fpt/tang-tiny-gpu/rtl/vdp/line_compositor.sv

// ラインごとの合成 (docs/ARCHITECTURE.md の段階 E1。M4 の fb_scanout を置き換えた)
//   論理画面 SRC_W x SRC_H を、ライン単位で合成して縦横 2 倍で出す。
//
//   合成: ラインを始めるときにレイヤのレジスタ (背景色・レイヤの有効・ビットマップの透過色と順位・タイル レイヤとスプライトの設定) を
//         取り込み、順位の付いた作業ライン (ピクセルごとに {順位, 色}) に、レイヤごとのパスで書く。
//         1. スプライト (有効なら): sprite_layer が OAM の順に出すピクセル。作業ラインがまだ空 (順位 0) のところだけ書くので、
//            スプライト同士は優先度ビットによらず OAM の前のものが勝つ (メガドラ・SNES と同じ)。順位は優先度ビットで RANK_S_LO / RANK_S_HI
//         2. タイルの面 (有効なら): 1 つの tile_layer を設定を変えて順に動かす。順位はタイルの優先度ビットで決まる
//            a. 面 B: RANK_B_LO / RANK_B_HI
//            b. 面 A: RANK_A_LO / RANK_A_HI。ウィンドウの範囲は書かない
//            c. ウィンドウ (範囲があるラインだけ): 面 A と同じ順位で、ウィンドウの範囲だけ書く。スクロールしない 64 x 32 のマップ
//               (win_map_base)。タイルの場所・パレットのバンク・エントリの並びは面 A のもの
//            ウィンドウの範囲 (メガドラと同じ): win_v ([5] 下, [4:0] 位置 x 8 ライン) でラインの上 / 下、
//            win_h ([5] 右, [4:0] 位置 x 16 ピクセル) で左 / 右。ラインが縦の範囲に入ればライン全体、でなければ横の範囲
//         3. ビットマップ レイヤ (有効なら): SDRAM のフレームバッファの行をバーストで読む。順位は bitmap_rank (既定 1)。
//            透過色が有効なら、透過色のピクセルは書かない。
//            8bpp (bitmap_fmt = 1) のときは行 (80 ワード) をいったん bm_buf に読み、1 クロックに 1 ピクセルずつパレット (0..255) を引いて書く。
//            透過色は bitmap_key[7:0] (パレットの番号)
//         4. 出力: 作業ラインをライン バッファに写し (順位 0 = どのレイヤも書かなかったところは背景色)、作業ラインを空に戻す。
//            ライトマップが有効 (layer_ctrl[5]) なら、ここで色にセルの倍率を掛ける (K4、下の「ライトマップ」)。行の倍率と加算 (霧、E7) もここ
//         2 と 3 は「不透明で、順位が今の値より大きいピクセルだけ」書くので、パスの順番によらず順位の高いものが残る (同じ順位なら先のパス)。
//         順位 (3bit): 0 背景色、1 面 B (低)、2 面 A (低)、3 スプライト (低)、4 面 B (高)、5 面 A (高)、6 スプライト (高)。
//   横スクロールの表 (hs_mode != 0): ラインを始めるときに VRAM の hs_base + 番号 の 1 ワードを読み、[25:16] を面 A、[9:0] を面 B の
//         横スクロールの値にする (メガドラの表をビッグエンディアンの 32bit ワードで読んだ並び。値の向きもメガドラと同じで、
//         正の値で面が右に動く = scroll_x = -値)。番号は hs_mode 1: 0 (画面全体)、2: ライン & ~7 (8 ラインごと)、3: ライン
//   VRAM (16K ワード x 32bit) とパレット (512 x RGB565) はここに置き、読み出しのポートを横スクロールの表・スプライト・タイルのパスが順番に使う。
//   Mode 7 (E7、mode7_layer.sv): M7_CTRL bit0 なら、面 A のタイルのパスの代わりに mode7_layer がピクセルを出す (順位は面 A と同じ。
//         ウィンドウは描かない)。ラインの先頭の計算 (setup) は横スクロールの表を読んだ直後に始め、スプライト・面 B のパスと同時に動く。
//         M7_CTRL[3:2] が 1 なら行列 {B, A}, {D, C} を VRAM の m7_tbl + 2 * ライン から、2 なら遠近の奥行き z を m7_tbl + ライン から読む
//   霧 (E7): 出力のパスで、各色 c を min(最大値, ((c * L_eff) >> 4) + ADD) にする。L_eff = min(63, (L_cell * L_line) >> 4)
//         (L_cell はライトマップのセル、ライトマップが無効なら 16)、L_line = LINE_MUL (5bit x 3、16 = 1 倍)、ADD = LINE_ADD (RGB565)。
//         LINE_FX_CTRL bit0 なら {LINE_ADD, LINE_MUL} を VRAM の LINE_FX_BASE + ライン から読む。既定 (16 x 3、0) なら出力は変わらない
//   E7 のレジスタ (GPU の REG_WRITE 32..50 → xreg_idx 0..18): 0 M7_SEL、1 M7_CTRL、2..5 M7_A..D、6 M7_X0、7 M7_Y0、8 M7_HOFS、9 M7_VOFS、
//         10 M7_MAP_BASE、11 M7_PAT_BASE、12 M7_TBL_BASE、13 M7_SX、14 M7_SY、15 LINE_MUL、16 LINE_ADD、17 LINE_FX_CTRL、18 LINE_FX_BASE
//   レジスタはラインの合成を始めるときに取り込むので、GPU の WAIT_LINE n のあとの REG_WRITE はライン n から効く。
//   そのために、合成を始めるたびに line_start とライン番号 line_num を出す。
//
//   ビットマップ: ソースのライン y はワードアドレス (fb_base + y) * 256 から SRC_W / 2 ワード (8bpp は SRC_W / 4 ワード)。
//                 RGB565 は 1 ワードに 2 ピクセル (下位 16bit が偶数の x)、RGB565 = {R5, G6, B5}。
//                 8bpp は 1 ワードに 4 ピクセル (ピクセル x はバイト x % 4)
//   動き方:       ソースのライン n を表示しているあいだ (出力 2 ライン分) に、ライン n+1 を合成して 2 ライン分のライン バッファの
//                 空いているほうに書く。ライン 0 は最後から 2 本目のブランキング ラインで合成する (ほかのラインと同じく出力 2 ライン分の時間がある)。
//                 表示が始まるときに合成が終わっていなかったら underflow_count を 1 増やす。
//   fb_base:      ライン 0 を合成し始めるときにだけ取り込み、そのフレームの間は変えない。取り込んだクロックで base_latched を出す。
//   印:           mark_req を受けると、次にライン 0 から合成するフレームに印を付ける (mark_toggle を反転)。
//                 frame_crc がそのフレームの CRC を MARK_CRC に残す。ラインごとにレジスタを変えたフレームを比べるため。
//
//   ライトマップ: 8 x 8 ピクセルのセルごとの R, G, B の倍率 (6bit ずつ、16 = 1 倍、63 = 3.94 倍)。セル (cx, cy) は番号 cy * (SRC_W / 8) + cx
//                 (320 x 240 なら 40 x 30 = 1,200 セル)。出力のパスで、ピクセル (x, y) の各色 c に
//                 セル (x / 8, y / 8) の倍率 L を掛けて min(最大値, (c * L) >> 4) にする (背景色にも掛かる)。GPU の LIGHT_WRITE が書く
//   クロック: ピクセル側 (clk_pix) が「次のライン」をトグルで頼み、システム側 (clk_sys) が合成する。
//            頼むライン番号はトグルの前に確定し、次に頼むまで (出力 2 ライン以上) 変わらない。
//            表示 (vdp_video の fb_en) にかかわらず、映像のタイミングが動いていれば合成し続ける (WAIT_LINE が止まらないように)。
module line_compositor #(
    parameter int SRC_W   = 320,
    parameter int SRC_H   = 240,
    parameter int V_TOTAL = 525,
    parameter int VRAM_WORDS = 16384
) (
    // --- システムクロック側 ---
    input  logic        clk_sys,
    input  logic        rst_sys,
    input  logic [12:0] fb_base,          // 256 ワード単位。ライン 0 を合成し始めるときに取り込む
    output logic        base_latched,     // fb_base を取り込んだとき 1 クロック
    input  logic [15:0] bg_color,         // 背景色 (RGB565)
    input  logic [5:0]  layer_ctrl,       // bit0: ビットマップ レイヤ有効, bit1: ビットマップの透過色を有効, bit2: 面 A (とウィンドウ) 有効,
                                          // bit3: スプライト有効, bit4: 面 B 有効, bit5: ライトマップを掛ける
    input  logic [15:0] bitmap_key,       // ビットマップの透過色
    input  logic [2:0]  bitmap_rank,      // ビットマップ レイヤの順位 (既定 1)
    input  logic        bitmap_fmt,       // ビットマップの形式: 0 = RGB565、1 = 8bpp (パレットの番号)
    input  logic [9:0]  tile_scroll_x,    // 面 A (tile_layer.sv)
    input  logic [9:0]  tile_scroll_y,
    input  logic [13:0] tile_map_base,
    input  logic [13:0] tile_pat_base,
    input  logic [7:0]  tile_ctrl,
    input  logic [9:0]  tileb_scroll_x,   // 面 B
    input  logic [9:0]  tileb_scroll_y,
    input  logic [13:0] tileb_map_base,
    input  logic [13:0] tileb_pat_base,
    input  logic [7:0]  tileb_ctrl,
    input  logic [5:0]  win_h,            // ウィンドウ: {右, 位置 x 16 ピクセル}
    input  logic [5:0]  win_v,            //             {下, 位置 x 8 ライン}
    input  logic [13:0] win_map_base,
    input  logic [1:0]  hs_mode,          // 横スクロールの表: 0 なし (レジスタ)、1 画面全体、2 8 ラインごと、3 ラインごと
    input  logic [13:0] hs_base,
    input  logic [13:0] spr_pat_base,     // スプライト (sprite_layer.sv)
    input  logic [3:0]  spr_bank,
    input  logic [6:0]  spr_line_cols,
    input  logic        vram_we,          // VRAM・パレット・OAM の書き込み (GPU)。OAM は vram_waddr[7:0] と vram_wdata を使う
    input  logic [13:0] vram_waddr,
    input  logic [31:0] vram_wdata,
    input  logic        pal_we,
    input  logic [8:0]  pal_waddr,
    input  logic [15:0] pal_wdata,
    input  logic        oam_we,
    input  logic        light_we,         // ライトマップの書き込み: vram_waddr[10:0] のセルに {vram_wdata[21:16], [13:8], [5:0]}
    input  logic        xreg_we,          // E7 のレジスタの書き込み (GPU の REG_WRITE 32..50)
    input  logic [4:0]  xreg_idx,
    input  logic [15:0] xreg_data,
    input  logic        mark_req,         // 次のフレームに印を付ける (1 クロック)
    output logic        mark_toggle,      // 印を付けたフレームの合成を始めるたびに反転
    output logic        line_start,       // ラインの合成を始めたとき 1 クロック
    output logic [7:0]  line_num,         // 合成しているライン (line_start のあいだ有効、次まで保持)
    output logic        mem_req,
    output logic [20:0] mem_addr,
    output logic [8:0]  mem_len,
    input  logic        mem_ack,
    input  logic        mem_rvalid,
    input  logic [31:0] mem_rdata,
    output logic [7:0]  underflow_count,  // 飽和する
    // --- ピクセルクロック側 ---
    input  logic        clk_pix,
    input  logic        rst_pix,
    input  logic [10:0] x,                // 表示タイミング (video_timing の x, y)
    input  logic [9:0]  y,
    output logic [23:0] rgb               // x, y の 1 クロック後に有効
);
    localparam int WORDS = SRC_W / 2;
    localparam int VA_W  = $clog2(VRAM_WORDS);
    localparam logic [2:0] RANK_B_LO = 3'd1, RANK_B_HI = 3'd4, RANK_A_LO = 3'd2, RANK_A_HI = 3'd5,
                           RANK_S_LO = 3'd3, RANK_S_HI = 3'd6;

    // --- ライン バッファ (2 ライン x 256 ワード)。書き込みは clk_sys、読み出しは clk_pix ---
    logic [31:0] line_buf [0:511];

    // ================================================================ ピクセル側
    logic [8:0]  req_line;
    logic        req_toggle;
    logic        need;
    logic [8:0]  next_line;

    always_comb begin
        need      = 1'b0;
        next_line = '0;
        if (y == 10'(V_TOTAL - 2)) begin
            need = 1'b1;                                   // 最後から 2 本目のブランキング ライン: ライン 0
        end else if (y < 10'(2 * SRC_H - 2) && !y[0]) begin
            need      = 1'b1;                              // ライン n の 1 本目: ライン n+1
            next_line = 9'(y >> 1) + 9'd1;
        end
    end

    always_ff @(posedge clk_pix) begin
        if (rst_pix) begin
            req_toggle <= 1'b0;
            req_line   <= '0;
        end else if (x == 11'd0 && need) begin
            req_line   <= next_line;
            req_toggle <= ~req_toggle;
        end
    end

    logic [31:0] word;
    logic        upper;
    always_ff @(posedge clk_pix) begin
        word  <= line_buf[{y[1], x[9:2]}];   // ソースのライン y>>1 の偶奇でバッファを選ぶ
        upper <= x[1];
    end

    logic [15:0] p;
    assign p   = upper ? word[31:16] : word[15:0];
    assign rgb = {p[15:11], p[15:13], p[10:5], p[10:9], p[4:0], p[4:2]};

    // ================================================================ システム側
    // 作業ライン: ピクセルごとに {順位 3bit, 色 16bit}。偶数の x と奇数の x を別の BSRAM に置き、1 クロックに 2 ピクセル読み書きできる。
    // 書き込みは「不透明で、順位が今の値より大きいときだけ」。今の値は 1 クロック前に読んでおく (rd_addr を先に出す)
    logic [18:0] wl_even [0:255];
    logic [18:0] wl_odd  [0:255];
    logic [7:0]  wl_rd_addr;
    logic [18:0] wl_q_even, wl_q_odd;
    logic        wl_we_even, wl_we_odd;
    logic [7:0]  wl_wa_even, wl_wa_odd;
    logic [18:0] wl_wd_even, wl_wd_odd;

    always_ff @(posedge clk_sys) begin
        if (wl_we_even) wl_even[wl_wa_even] <= wl_wd_even;
        if (wl_we_odd)  wl_odd[wl_wa_odd]   <= wl_wd_odd;
        wl_q_even <= wl_even[wl_rd_addr];
        wl_q_odd  <= wl_odd[wl_rd_addr];
    end

    typedef enum logic [1:0] {TP_B, TP_A, TP_W, TP_NONE} tpass_t;      // タイルのパス
    typedef enum logic [3:0] {P_IDLE, P_HS, P_SPRITE, P_TILE, P_ISSUE, P_BITMAP, P_BM8, P_OUT_PRE, P_OUT} phase_t;
    phase_t phase;

    logic [2:0]  req_s;
    logic        busy, pending, mark_pending;
    logic        line_bank;      // 合成しているラインを書くバッファ (ライン番号の偶奇)
    logic [12:0] frame_base;     // このフレームで使う fb_base
    logic [7:0]  widx;           // ビットマップのパスで書くワード
    logic [7:0]  oidx;           // 出力のパスで書くワード
    // このラインのレジスタ (合成を始めるときに取り込む)
    logic [15:0] l_bg, l_key;
    logic        l_key_en, l_bm_en, l_tile_en, l_b_en, l_spr_en, l_fmt8, l_light;
    logic [2:0]  l_bm_rank;
    logic [9:0]  l_sx, l_sy;
    logic [13:0] l_map, l_pat;
    logic [7:0]  l_tctrl;
    logic [9:0]  l_bsx, l_bsy;
    logic [13:0] l_bmap, l_bpat;
    logic [7:0]  l_bctrl;
    logic [5:0]  l_wh, l_wv;
    logic [13:0] l_wmap;
    logic [1:0]  l_hs_mode;
    logic [13:0] l_hs_base;
    logic [9:0]  hs_a, hs_b;     // 横スクロールの表から読んだ値
    logic [13:0] l_spat;
    logic [3:0]  l_sbank;
    logic [6:0]  l_scols;
    logic [20:0] l_addr;         // ビットマップの行のアドレス
    // E7 のレジスタ (今の値) と、このラインの値
    logic [3:0]  m7_sel;         // M7_SEL の {[7:6], [1:0]}
    logic [3:0]  m7_ctrl;
    logic [15:0] m7_a, m7_b, m7_c, m7_d;
    logic [12:0] m7_x0, m7_y0, m7_hofs, m7_vofs;
    logic [13:0] m7_map, m7_pat, m7_tbl, fx_base;
    logic [9:0]  m7_sx;
    logic [8:0]  m7_sy;
    logic [14:0] fx_mul;
    logic [15:0] fx_add;
    logic        fx_tab;
    logic        l_m7, l_extbg, l_fx_tab;
    logic [1:0]  l_m7_tab, l_flip, l_over;
    logic [15:0] l_m7a, l_m7b, l_m7c, l_m7d, l_z;
    logic [12:0] l_x0, l_y0, l_hofs, l_vofs;
    logic [13:0] l_m7map, l_m7pat, l_m7tbl, l_fxbase;
    logic [9:0]  l_m7sx;
    logic [8:0]  l_m7sy;
    logic [14:0] l_mul;
    logic [15:0] l_add;
    logic [2:0]  rd_k;           // ラインの先頭で VRAM から読む表の番号 (横スクロール、Mode 7 の 2 語、霧)
    logic        m_setup, m_start, m_busy, m_valid, m_pri;
    logic [7:0]  m_next;
    logic [8:0]  m_x;
    logic [15:0] m_color;
    logic [13:0] m_vram_raddr;
    logic [8:0]  m_pal_raddr;
    logic        m7_pass;        // 面 A のパスを Mode 7 で描いている
    logic        t_start, t_busy, tl_busy;
    // 動かしているタイルのパス。yosys の FSM の抽出が符号を付け直すと $buf が残って nextpnr が置けないので、ふつうのレジスタのままにする
    (* fsm_encoding = "none" *) tpass_t tpass;
    logic [9:0]  t_sx, t_sy;
    logic [13:0] t_map, t_pat;
    logic [7:0]  t_ctrl;
    logic        t_valid, t_opaque, t_pri, tl_valid, tl_opaque, tl_pri;
    logic [7:0]  t_next, tl_next;
    logic [8:0]  t_x, tl_x;
    logic [15:0] t_color, tl_color;
    logic        s_start, s_busy;
    logic        s_valid, s_pri;
    logic [7:0]  s_next;
    logic [8:0]  s_x;
    logic [15:0] s_color;

    assign busy = phase != P_IDLE;

    // VRAM とパレット。読み出しは 横スクロールの表 (P_HS)、スプライトのパスのあいだ sprite_layer、それ以外は tile_layer
    logic [31:0] vram [0:VRAM_WORDS-1];
    logic [15:0] pal  [0:511];
    logic [13:0] vram_raddr, t_vram_raddr, s_vram_raddr, tl_vram_raddr;
    logic [8:0]  pal_raddr, t_pal_raddr, s_pal_raddr, tl_pal_raddr;
    logic [31:0] vram_q;
    logic [15:0] pal_q;
    logic [13:0] hs_addr;
    always_comb begin
        unique case (l_hs_mode)
            2'd2:    hs_addr = l_hs_base + 14'({line_num[7:3], 3'b000});
            2'd3:    hs_addr = l_hs_base + 14'(line_num);
            default: hs_addr = l_hs_base;
        endcase
    end
    // ラインの先頭で読む表: rd_k = 0 横スクロール、1 / 2 Mode 7 (直接は 2 語、遠近は 1 語)、3 霧
    logic [13:0] tab_addr;
    always_comb begin
        unique case (rd_k)
            3'd0:    tab_addr = hs_addr;
            3'd1:    tab_addr = (l_m7_tab == 2'd1) ? l_m7tbl + 14'({line_num, 1'b0}) : l_m7tbl + 14'(line_num);
            3'd2:    tab_addr = l_m7tbl + 14'({line_num, 1'b1});
            default: tab_addr = l_fxbase + 14'(line_num);
        endcase
    end
    assign vram_raddr = (phase == P_SPRITE) ? s_vram_raddr : (phase == P_HS) ? tab_addr : t_vram_raddr;
    // 8bpp のビットマップ: 行を読んでおくバッファと、パレットを引くパイプライン
    //   bi のクロック: bm_buf を読む → 1 段目 (p1): バイトを選んでパレットと作業ラインを読む → 2 段目 (p2): 作業ラインに書く
    logic [31:0] bm_buf [0:127];
    logic [31:0] bm_q;
    logic [8:0]  bi, p1_x, p2_x;
    logic        p1_v, p2_v, p2_tr;
    logic [7:0]  p1_idx;
    always_ff @(posedge clk_sys) begin
        if (phase == P_BITMAP && mem_rvalid) bm_buf[widx[6:0]] <= mem_rdata;
        bm_q <= bm_buf[bi[8:2]];
    end
    assign p1_idx = bm_q[{p1_x[1:0], 3'b0} +: 8];

    assign pal_raddr  = (phase == P_SPRITE) ? s_pal_raddr : (phase == P_BM8) ? {1'b0, p1_idx} : t_pal_raddr;

    always_ff @(posedge clk_sys) begin
        if (vram_we) vram[VA_W'(vram_waddr)] <= vram_wdata;
        vram_q <= vram[VA_W'(vram_raddr)];
    end
    always_ff @(posedge clk_sys) begin
        if (pal_we) pal[pal_waddr] <= pal_wdata;
        pal_q <= pal[pal_raddr];
    end

    sprite_layer #(.SRC_W(SRC_W)) u_sprite (
        .clk(clk_sys), .rst(rst_sys),
        .oam_we, .oam_waddr(vram_waddr[7:0]), .oam_wdata(vram_wdata),
        .vram_raddr(s_vram_raddr), .vram_q, .pal_raddr(s_pal_raddr), .pal_q,
        .start(s_start), .line(line_num), .pat_base(l_spat), .bank(l_sbank), .line_cols(l_scols), .busy(s_busy),
        .next_word(s_next), .px_valid(s_valid), .px_x(s_x), .px_pri(s_pri), .px_color(s_color)
    );

    tile_layer #(.SRC_W(SRC_W)) u_tile (
        .clk(clk_sys), .rst(rst_sys),
        .vram_raddr(tl_vram_raddr), .vram_q, .pal_raddr(tl_pal_raddr), .pal_q,
        .start(t_start && !m7_pass), .line(line_num), .scroll_x(t_sx), .scroll_y(t_sy), .map_base(t_map), .pat_base(t_pat),
        .ctrl(t_ctrl), .busy(tl_busy), .next_word(tl_next),
        .px_valid(tl_valid), .px_x(tl_x), .px_opaque(tl_opaque), .px_pri(tl_pri), .px_color(tl_color)
    );

    mode7_layer #(.SRC_W(SRC_W)) u_mode7 (
        .clk(clk_sys), .rst(rst_sys),
        .vram_raddr(m_vram_raddr), .vram_q, .pal_raddr(m_pal_raddr), .pal_q,
        .setup(m_setup), .line(line_num), .flip(l_flip), .over(l_over), .extbg(l_extbg), .persp(l_m7_tab == 2'd2),
        .a(l_m7a), .b(l_m7b), .c(l_m7c), .d(l_m7d), .z(l_z), .x0(l_x0), .y0(l_y0), .hofs(l_hofs), .vofs(l_vofs),
        .sx(l_m7sx), .sy(l_m7sy), .map_base(l_m7map), .pat_base(l_m7pat),
        .start(m_start), .busy(m_busy), .next_word(m_next),
        .px_valid(m_valid), .px_x(m_x), .px_pri(m_pri), .px_color(m_color)
    );

    // 面 A のパスを Mode 7 で描くとき (m7_pass)、タイルのパスの信号を mode7_layer のものにする
    assign m7_pass       = l_m7 && tpass == TP_A;
    assign m_start       = t_start && m7_pass;
    assign t_busy        = m7_pass ? m_busy : tl_busy;
    assign t_next        = m7_pass ? m_next : tl_next;
    assign t_valid       = m7_pass ? m_valid : tl_valid;
    assign t_x           = m7_pass ? m_x : tl_x;
    assign t_opaque      = m7_pass ? 1'b1 : tl_opaque;
    assign t_pri         = m7_pass ? m_pri : tl_pri;
    assign t_color       = m7_pass ? m_color : tl_color;
    assign t_vram_raddr  = m7_pass ? m_vram_raddr : tl_vram_raddr;
    assign t_pal_raddr   = m7_pass ? m_pal_raddr : tl_pal_raddr;

    // タイルのパスごとの設定 (パスのあいだは変わらない)
    logic hs_on;
    assign hs_on = l_hs_mode != 2'd0;
    always_comb begin
        unique case (tpass)
            TP_B: begin
                t_sx = hs_on ? 10'd0 - hs_b : l_bsx;  t_sy = l_bsy;
                t_map = l_bmap;  t_pat = l_bpat;  t_ctrl = l_bctrl;
            end
            TP_W: begin
                t_sx = '0;  t_sy = '0;
                t_map = l_wmap;  t_pat = l_pat;  t_ctrl = {l_tctrl[7:4], 2'd0, 2'd1};    // 64 x 32、面 A のバンクと並び
            end
            default: begin
                t_sx = hs_on ? 10'd0 - hs_a : l_sx;  t_sy = l_sy;
                t_map = l_map;  t_pat = l_pat;  t_ctrl = l_tctrl;
            end
        endcase
    end

    // ウィンドウの範囲
    logic [8:0] win_h16;
    logic [7:0] win_v8;
    logic       win_line, win_run, t_in_win;
    assign win_h16  = {l_wh[4:0], 4'b0};
    assign win_v8   = {l_wv[4:0], 3'b0};
    assign win_line = l_wv[5] ? line_num >= win_v8 : line_num < win_v8;
    assign win_run  = win_line || (l_wh[5] ? win_h16 < 9'(SRC_W) : win_h16 != 9'd0);
    assign t_in_win = win_line || (l_wh[5] ? t_x >= win_h16 : t_x < win_h16);

    // 次のタイルのパス: B → A → ウィンドウ の順に、有効なもの
    tpass_t     tp_first, tp_after;
    logic       en_w;
    assign en_w     = l_tile_en && win_run && !l_m7;      // Mode 7 のあいだはウィンドウを描かない
    // (Icarus Verilog は enum の三項演算子の代入を受け付けないので if で書く)
    always_comb begin
        if (l_b_en)         tp_first = TP_B;
        else if (l_tile_en) tp_first = TP_A;
        else if (en_w)      tp_first = TP_W;
        else                tp_first = TP_NONE;
        tp_after = TP_NONE;
        unique case (tpass)
            TP_B: if (l_tile_en) tp_after = TP_A; else if (en_w) tp_after = TP_W;
            TP_A: if (en_w) tp_after = TP_W;
            default: ;
        endcase
    end

    always_ff @(posedge clk_sys) req_s <= {req_s[1:0], req_toggle};

    // 作業ラインの読み出しアドレス: そのパスで次のクロックに書くところ
    always_comb begin
        unique case (phase)
            P_SPRITE: wl_rd_addr = s_next;
            P_TILE:   wl_rd_addr = t_next;
            P_BITMAP: wl_rd_addr = mem_rvalid ? widx + 8'd1 : widx;
            P_BM8:    wl_rd_addr = p1_x[8:1];
            P_OUT:    wl_rd_addr = oidx + 8'd1;
            default:  wl_rd_addr = 8'd0;
        endcase
    end

    // 作業ラインへの書き込み
    logic [2:0] t_rank, s_rank;
    logic       t_ok, bm_lo_ok, bm_hi_ok;
    assign t_rank   = (tpass == TP_B) ? (t_pri ? RANK_B_HI : RANK_B_LO) : (t_pri ? RANK_A_HI : RANK_A_LO);
    assign t_ok     = t_valid && t_opaque && (tpass == TP_A ? (l_m7 || !t_in_win) : tpass == TP_W ? t_in_win : 1'b1);
    assign s_rank   = s_pri ? RANK_S_HI : RANK_S_LO;
    assign bm_lo_ok = !(l_key_en && mem_rdata[15:0] == l_key) && l_bm_rank > wl_q_even[18:16];
    assign bm_hi_ok = !(l_key_en && mem_rdata[31:16] == l_key) && l_bm_rank > wl_q_odd[18:16];
    always_comb begin
        wl_we_even = 1'b0; wl_wa_even = widx; wl_wd_even = {l_bm_rank, mem_rdata[15:0]};
        wl_we_odd  = 1'b0; wl_wa_odd  = widx; wl_wd_odd  = {l_bm_rank, mem_rdata[31:16]};
        unique case (phase)
            // スプライト: 空いているところだけ (OAM の前のスプライトが勝つ)。sprite_layer は不透明なピクセルだけ出す
            P_SPRITE: begin
                wl_wa_even = s_x[8:1];  wl_wd_even = {s_rank, s_color};
                wl_wa_odd  = s_x[8:1];  wl_wd_odd  = {s_rank, s_color};
                wl_we_even = s_valid && !s_x[0] && wl_q_even[18:16] == 3'd0;
                wl_we_odd  = s_valid &&  s_x[0] && wl_q_odd[18:16] == 3'd0;
            end
            P_TILE: begin
                wl_wa_even = t_x[8:1];  wl_wd_even = {t_rank, t_color};
                wl_wa_odd  = t_x[8:1];  wl_wd_odd  = {t_rank, t_color};
                wl_we_even = t_ok && !t_x[0] && t_rank > wl_q_even[18:16];
                wl_we_odd  = t_ok &&  t_x[0] && t_rank > wl_q_odd[18:16];
            end
            P_BITMAP: begin
                wl_we_even = mem_rvalid && bm_lo_ok && !l_fmt8;
                wl_we_odd  = mem_rvalid && bm_hi_ok && !l_fmt8;
            end
            P_BM8: begin
                wl_wa_even = p2_x[8:1];  wl_wd_even = {l_bm_rank, pal_q};
                wl_wa_odd  = p2_x[8:1];  wl_wd_odd  = {l_bm_rank, pal_q};
                wl_we_even = p2_v && !p2_tr && !p2_x[0] && l_bm_rank > wl_q_even[18:16];
                wl_we_odd  = p2_v && !p2_tr &&  p2_x[0] && l_bm_rank > wl_q_odd[18:16];
            end
            P_OUT: begin
                // 写したところを空 (順位 0) に戻して、次のラインに備える
                wl_wa_even = oidx; wl_wd_even = '0; wl_we_even = 1'b1;
                wl_wa_odd  = oidx; wl_wd_odd  = '0; wl_we_odd  = 1'b1;
            end
            default: ;
        endcase
    end

    // 出力のパス: 作業ラインをライン バッファに写す。順位 0 (どのレイヤも書かなかった) は背景色
    // ライトマップ: 作業ラインを読むワード (wl_rd_addr、2 ピクセル) のセルを同じクロックに読むので、出力のパスでは作業ラインの値とそろう
    localparam int LM_W = SRC_W / 8;
    logic [17:0] lm [0:2047];
    logic [17:0] lm_q;
    logic [10:0] lm_raddr;
    assign lm_raddr = 11'(line_num[7:3]) * 11'(LM_W) + 11'(wl_rd_addr[7:2]);
    always_ff @(posedge clk_sys) begin
        if (light_we) lm[vram_waddr[10:0]] <= {vram_wdata[21:16], vram_wdata[13:8], vram_wdata[5:0]};
        lm_q <= lm[lm_raddr];
    end

    // 色 c (RGB565) にセルの倍率 l ({B, G, R}) を掛ける: 各色 min(最大値, (c * L) >> 4)
    function automatic logic [15:0] lit(input logic [15:0] c, input logic [17:0] l);
        logic [6:0] r, b;
        logic [7:0] g;
        r = 7'((11'(c[15:11]) * 11'(l[5:0])) >> 4);
        g = 8'((12'(c[10:5])  * 12'(l[11:6])) >> 4);
        b = 7'((11'(c[4:0])   * 11'(l[17:12])) >> 4);
        return {(r[6:5] != 2'd0) ? 5'd31 : r[4:0], (g[7:6] != 2'd0) ? 6'd63 : g[5:0], (b[6:5] != 2'd0) ? 5'd31 : b[4:0]};
    endfunction

    // 霧 (E7): セルの倍率に行の倍率 (l_mul、5bit x 3) を掛けて 63 で切る。ライトマップが無効ならセルの倍率は 16
    function automatic logic [5:0] mul_sat(input logic [5:0] cl, input logic [4:0] ln);
        logic [6:0] q;
        q = 7'((11'(cl) * 11'(ln)) >> 4);
        return q[6] ? 6'd63 : q[5:0];
    endfunction
    // 色 c に行の加算 (RGB565) を各色で足して最大値で切る
    function automatic logic [15:0] add_sat(input logic [15:0] c, input logic [15:0] k);
        logic [5:0] r, b;
        logic [6:0] g;
        r = 6'(c[15:11]) + 6'(k[15:11]);
        g = 7'(c[10:5])  + 7'(k[10:5]);
        b = 6'(c[4:0])   + 6'(k[4:0]);
        return {r[5] ? 5'd31 : r[4:0], g[6] ? 6'd63 : g[5:0], b[5] ? 5'd31 : b[4:0]};
    endfunction

    // 出力は 2 段: 1 段目 (P_OUT) で背景色を選び L_eff を出し、2 段目で掛けて足してライン バッファに書く
    logic [15:0] out_lo, out_hi;
    logic [17:0] l_cell, l_eff;
    assign out_lo = (wl_q_even[18:16] == 3'd0) ? l_bg : wl_q_even[15:0];
    assign out_hi = (wl_q_odd[18:16] == 3'd0) ? l_bg : wl_q_odd[15:0];
    assign l_cell = l_light ? lm_q : {6'd16, 6'd16, 6'd16};
    assign l_eff  = {mul_sat(l_cell[17:12], l_mul[14:10]), mul_sat(l_cell[11:6], l_mul[9:5]), mul_sat(l_cell[5:0], l_mul[4:0])};

    logic        o_we, o_bank;
    logic [7:0]  o_idx;
    logic [15:0] o_lo, o_hi;
    logic [17:0] o_l;
    always_ff @(posedge clk_sys) begin
        o_we   <= phase == P_OUT;
        o_bank <= line_bank;
        o_idx  <= oidx;
        o_lo   <= out_lo;
        o_hi   <= out_hi;
        o_l    <= l_eff;
        if (o_we) line_buf[{o_bank, o_idx}] <= {add_sat(lit(o_hi, o_l), l_add), add_sat(lit(o_lo, o_l), l_add)};
    end

    assign mem_len = l_fmt8 ? 9'(SRC_W / 4) : 9'(WORDS);

    // E7 のレジスタ
    always_ff @(posedge clk_sys) begin
        if (rst_sys) begin
            m7_sel  <= '0;  m7_ctrl <= '0;
            m7_a    <= 16'h0100;  m7_b <= '0;  m7_c <= '0;  m7_d <= 16'h0100;
            m7_x0   <= '0;  m7_y0   <= '0;  m7_hofs <= '0;  m7_vofs <= '0;
            m7_map  <= '0;  m7_pat  <= '0;  m7_tbl  <= '0;
            m7_sx   <= '0;  m7_sy   <= '0;
            fx_mul  <= {5'd16, 5'd16, 5'd16};
            fx_add  <= '0;  fx_tab  <= 1'b0;  fx_base <= '0;
        end else if (xreg_we) begin
            unique case (xreg_idx)
                5'd0:  m7_sel  <= {xreg_data[7:6], xreg_data[1:0]};
                5'd1:  m7_ctrl <= xreg_data[3:0];
                5'd2:  m7_a    <= xreg_data;
                5'd3:  m7_b    <= xreg_data;
                5'd4:  m7_c    <= xreg_data;
                5'd5:  m7_d    <= xreg_data;
                5'd6:  m7_x0   <= xreg_data[12:0];
                5'd7:  m7_y0   <= xreg_data[12:0];
                5'd8:  m7_hofs <= xreg_data[12:0];
                5'd9:  m7_vofs <= xreg_data[12:0];
                5'd10: m7_map  <= xreg_data[13:0];
                5'd11: m7_pat  <= xreg_data[13:0];
                5'd12: m7_tbl  <= xreg_data[13:0];
                5'd13: m7_sx   <= xreg_data[9:0];
                5'd14: m7_sy   <= xreg_data[8:0];
                5'd15: fx_mul  <= xreg_data[14:0];
                5'd16: fx_add  <= xreg_data;
                5'd17: fx_tab  <= xreg_data[0];
                5'd18: fx_base <= xreg_data[13:0];
                default: ;
            endcase
        end
    end

    always_ff @(posedge clk_sys) begin
        if (rst_sys) begin
            phase           <= P_IDLE;
            pending         <= 1'b0;
            mem_req         <= 1'b0;
            underflow_count <= '0;
            frame_base      <= '0;
            base_latched    <= 1'b0;
            line_start      <= 1'b0;
            line_num        <= '0;
            mark_pending    <= 1'b0;
            mark_toggle     <= 1'b0;
            t_start         <= 1'b0;
            s_start         <= 1'b0;
            m_setup         <= 1'b0;
            tpass           <= TP_A;
        end else begin
            base_latched <= 1'b0;
            line_start   <= 1'b0;
            t_start      <= 1'b0;
            s_start      <= 1'b0;
            m_setup      <= 1'b0;
            if (mark_req) mark_pending <= 1'b1;

            // 新しい依頼が来たときにまだ合成していたら、表示に間に合っていない
            if (req_s[2] != req_s[1]) begin
                if (busy && underflow_count != 8'hFF) underflow_count <= underflow_count + 8'd1;
                pending <= 1'b1;
            end

            unique case (phase)
                P_IDLE: if (pending || req_s[2] != req_s[1]) begin
                    pending    <= 1'b0;
                    line_bank  <= req_line[0];
                    line_start <= 1'b1;
                    line_num   <= 8'(req_line);
                    l_bg       <= bg_color;
                    l_key      <= bitmap_key;
                    l_key_en   <= layer_ctrl[1];
                    l_bm_en    <= layer_ctrl[0];
                    l_tile_en  <= layer_ctrl[2];
                    l_spr_en   <= layer_ctrl[3];
                    l_b_en     <= layer_ctrl[4];
                    l_light    <= layer_ctrl[5];
                    l_bsx      <= tileb_scroll_x;
                    l_bsy      <= tileb_scroll_y;
                    l_bmap     <= tileb_map_base;
                    l_bpat     <= tileb_pat_base;
                    l_bctrl    <= tileb_ctrl;
                    l_wh       <= win_h;
                    l_wv       <= win_v;
                    l_wmap     <= win_map_base;
                    l_hs_mode  <= hs_mode;
                    l_hs_base  <= hs_base;
                    l_bm_rank  <= bitmap_rank;
                    l_fmt8     <= bitmap_fmt;
                    l_sx       <= tile_scroll_x;
                    l_sy       <= tile_scroll_y;
                    l_map      <= tile_map_base;
                    l_pat      <= tile_pat_base;
                    l_tctrl    <= tile_ctrl;
                    l_spat     <= spr_pat_base;
                    l_sbank    <= spr_bank;
                    l_scols    <= spr_line_cols;
                    l_m7       <= m7_ctrl[0];
                    l_extbg    <= m7_ctrl[1];
                    l_m7_tab   <= m7_ctrl[3:2];
                    l_flip     <= m7_sel[1:0];
                    l_over     <= m7_sel[3:2];
                    l_m7a      <= m7_a;
                    l_m7b      <= m7_b;
                    l_m7c      <= m7_c;
                    l_m7d      <= m7_d;
                    l_x0       <= m7_x0;
                    l_y0       <= m7_y0;
                    l_hofs     <= m7_hofs;
                    l_vofs     <= m7_vofs;
                    l_m7map    <= m7_map;
                    l_m7pat    <= m7_pat;
                    l_m7tbl    <= m7_tbl;
                    l_m7sx     <= m7_sx;
                    l_m7sy     <= m7_sy;
                    l_mul      <= fx_mul;
                    l_add      <= fx_add;
                    l_fx_tab   <= fx_tab;
                    l_fxbase   <= fx_base;
                    rd_k       <= '0;
                    l_addr     <= (req_line == 9'd0) ? {fb_base, 8'b0} : {frame_base + 13'(req_line), 8'b0};
                    widx       <= '0;
                    if (req_line == 9'd0) begin
                        frame_base   <= fb_base;
                        base_latched <= 1'b1;
                        if (mark_pending || mark_req) begin
                            mark_toggle  <= ~mark_toggle;
                            mark_pending <= 1'b0;
                        end
                    end
                    phase <= P_HS;
                end
                // ラインの先頭の表を読む。横スクロールの表は使わないときも読むだけ読む (rd_k = 0)。Mode 7 か霧の表を使うときだけ
                // 続けて 3 語 (rd_k = 1..3) 読む。アドレスを出した次のクロックにデータ (rd_k = 1..4 で受ける)
                P_HS: begin
                    rd_k <= rd_k + 3'd1;
                    unique case (rd_k)
                        3'd1: begin
                            hs_a <= vram_q[25:16];
                            hs_b <= vram_q[9:0];
                        end
                        3'd2: begin
                            if (l_m7_tab == 2'd1) begin
                                l_m7a <= vram_q[15:0];
                                l_m7b <= vram_q[31:16];
                            end
                            if (l_m7_tab == 2'd2) l_z <= vram_q[15:0];
                        end
                        3'd3: if (l_m7_tab == 2'd1) begin
                            l_m7c <= vram_q[15:0];
                            l_m7d <= vram_q[31:16];
                        end
                        3'd4: if (l_fx_tab) begin
                            l_mul <= vram_q[14:0];
                            l_add <= vram_q[31:16];
                        end
                        default: ;
                    endcase
                    if (rd_k == ((l_m7_tab != 2'd0 || l_fx_tab) ? 3'd4 : 3'd1)) begin
                        m_setup <= l_m7;      // Mode 7 のラインの先頭の計算は、ここからスプライト・面 B のパスと同時に
                        if (l_spr_en) begin
                            s_start <= 1'b1;
                            phase   <= P_SPRITE;
                        end else if (tp_first != TP_NONE) begin
                            tpass   <= tp_first;
                            t_start <= 1'b1;
                            phase   <= P_TILE;
                        end else begin
                            phase <= P_ISSUE;
                        end
                    end
                end
                // s_start / t_start のクロックの busy はまだ 0 (次のクロックから busy)
                P_SPRITE: if (!s_start && !s_busy) begin
                    if (tp_first != TP_NONE) begin
                        tpass   <= tp_first;
                        t_start <= 1'b1;
                        phase   <= P_TILE;
                    end else begin
                        phase <= P_ISSUE;
                    end
                end
                P_TILE: if (!t_start && !t_busy) begin
                    if (tp_after != TP_NONE) begin
                        tpass   <= tp_after;
                        t_start <= 1'b1;
                    end else begin
                        phase <= P_ISSUE;
                    end
                end
                P_ISSUE: begin
                    if (l_bm_en) begin
                        mem_req  <= 1'b1;
                        mem_addr <= l_addr;
                        phase    <= P_BITMAP;
                    end else begin
                        phase <= P_OUT_PRE;
                    end
                end
                P_BITMAP: begin
                    if (mem_rvalid) widx <= widx + 8'd1;
                    if (mem_ack) begin
                        mem_req <= 1'b0;
                        bi      <= '0;
                        p1_v    <= 1'b0;
                        p2_v    <= 1'b0;
                        if (l_fmt8) phase <= P_BM8;
                        else        phase <= P_OUT_PRE;
                    end
                end
                // 8bpp: 1 クロックに 1 ピクセル。最後のピクセル (SRC_W - 1) は bi = SRC_W + 1 のクロックで書く
                P_BM8: begin
                    bi    <= bi + 9'd1;
                    p1_v  <= bi < 9'(SRC_W);
                    p1_x  <= bi;
                    p2_v  <= p1_v;
                    p2_x  <= p1_x;
                    p2_tr <= l_key_en && p1_idx == l_key[7:0];
                    if (bi == 9'(SRC_W + 1)) phase <= P_OUT_PRE;
                end
                // 作業ラインのワード 0 を読むための 1 クロック
                P_OUT_PRE: begin
                    oidx  <= '0;
                    phase <= P_OUT;
                end
                P_OUT: begin
                    oidx <= oidx + 8'd1;
                    if (oidx == 8'(WORDS - 1)) phase <= P_IDLE;
                end
                default: phase <= P_IDLE;
            endcase
        end
    end
endmodule
