fpt/tang-tiny-gpu/sim/scenario/gpu_scenario_tb.sv

// シナリオをシステム全体の RTL で走らせる (docs/ARCHITECTURE.md の段階 M5、「3 通りの比較」の Verilator の分)
//   gpu + sdram_arb + sdram_ctrl + SDRAM の振る舞いモデル + fb_scanout + vdp_video + frame_crc。SPI は通さず、レジスタバスを直接叩く。
//   入力 (gpu_model.py export が作る):
//     +cmds=<file>    1 行 1 ワード (16 進) のコマンド列
//     +checks=<file>  1 行 1 つ、「check の位置 (そこまでに送るワード数、10 進) 種類 (0 = 普通、1 = 印を付けたフレーム)」
//     +out=<dir>      check ごとに crc_<i>.txt (FRAME_CRC、CRC_FRAME、UNDERFLOW、表示の読み出しの最大待ち) と frame_<i>.ppm を書く
//   普通の check では、GPU が空になったあと 2 フレーム待ち、その次のフレームの CRC を記録する (実機の harness.py scenario と同じ)。
//   印の check では、そこまでを送ったあと、印を付けたフレーム (WAIT_VBLANK、印付き) が終わるのを待ち、そのフレームを記録する。
//   実行は make scenario (Verilator) だけ。640x480 のフレームを何枚も回すので Icarus では遅すぎる。
//   GPU3D = 1 (scenarios/gpu3d/ のシナリオ) なら、line_compositor の代わりに fb_line (3D GPU のビットストリームと同じ表示)
`timescale 1ns/1ps
module gpu_scenario_tb #(
    parameter int GPU3D = 0
);
    logic clk_sys = 0, clk_pix = 0, rst = 1;
    always #7.936 clk_sys = ~clk_sys;    // 63MHz
    always #19.841 clk_pix = ~clk_pix;   // 25.2MHz

    // --- レジスタバス (gpu だけ) ---
    logic [6:0] addr = '0;
    logic [7:0] wdata = '0, rdata;
    logic       we = 0, re = 0;

    // --- 映像 ---
    logic [10:0] vx;
    logic [9:0]  vy;
    logic [7:0]  r, g, b;
    logic        de, hsync, vsync, vblank, frame_start;
    logic [23:0] fb_rgb;
    vdp_video u_video (
        .clk_pix, .rst, .freeze(1'b0), .fb_en(1'b1), .fb_rgb, .x(vx), .y(vy),
        .r, .g, .b, .de, .hsync, .vsync, .vblank, .frame_start
    );

    logic [31:0] crc, held_crc;
    logic [15:0] crc_frame;
    logic [7:0]  mark_count;
    logic        crc_toggle, mark_toggle;
    frame_crc u_crc (.clk(clk_pix), .rst, .de, .r, .g, .b, .vblank, .crc, .frame(crc_frame), .crc_toggle,
                     .mark_toggle_async(mark_toggle), .held_crc, .mark_count);

    // --- SDRAM まわり ---
    logic [12:0] fb_base;
    logic        base_latched;
    logic [7:0]  underflow_count;

    logic        fb_req, fb_ack, fb_rvalid;
    logic [20:0] fb_addr;
    logic [8:0]  fb_len;
    logic        g_req, g_we, g_ack, g_wnext, g_rvalid;
    logic [20:0] g_addr;
    logic [31:0] g_wdata;
    logic [3:0]  g_wmask;
    logic [8:0]  g_len;
    logic        m_req, m_we, m_ack, m_rvalid, m_wnext, init_done;
    logic [20:0] m_addr;
    logic [31:0] m_wdata, m_rdata;
    logic [3:0]  m_wmask;
    logic [8:0]  m_len;

    logic [15:0] bg_color, bitmap_key;
    logic [2:0]  bitmap_rank;
    logic        bitmap_fmt;
    logic [5:0]  layer_ctrl;
    logic        light_we;
    logic        xreg_we;           // E7 のレジスタ (gpu -> line_compositor)
    logic [4:0]  xreg_idx;
    logic [15:0] xreg_data;
    logic [9:0]  tileb_scroll_x, tileb_scroll_y;
    logic [13:0] tileb_map_base, tileb_pat_base, win_map_base, hs_base;
    logic [7:0]  tileb_ctrl;
    logic [5:0]  win_h, win_v;
    logic [1:0]  hs_mode;
    // タイル レイヤのレジスタと、VRAM / パレットの書き込み (gpu -> line_compositor)
    logic [9:0]  tile_scroll_x, tile_scroll_y;
    logic [13:0] tile_map_base, tile_pat_base, vram_waddr;
    logic [7:0]  tile_ctrl;
    logic [13:0] spr_pat_base;
    logic [3:0]  spr_bank;
    logic [6:0]  spr_line_cols;
    logic        oam_we;
    logic        vram_we, pal_we;
    logic [31:0] vram_wdata;
    logic [8:0]  pal_waddr;
    logic [15:0] pal_wdata;
    logic        mark_req, line_start, gpu_ready;
    logic [7:0]  line_num;

    logic comp_busy;
    if (GPU3D != 0) begin : g_fb
        fb_line u_fb (
            .clk_sys, .rst_sys(rst), .fb_base, .base_latched,
            .bg_color, .layer_ctrl(layer_ctrl[1:0]), .bitmap_key, .mark_req, .mark_toggle, .line_start, .line_num,
            .mem_req(fb_req), .mem_addr(fb_addr), .mem_len(fb_len), .mem_ack(fb_ack),
            .mem_rvalid(fb_rvalid), .mem_rdata(m_rdata), .underflow_count,
            .clk_pix, .rst_pix(rst), .x(vx), .y(vy), .rgb(fb_rgb)
        );
        assign comp_busy = u_fb.phase != u_fb.P_IDLE;
    end else begin : g_comp
        line_compositor u_comp (
            .clk_sys, .rst_sys(rst), .fb_base, .base_latched,
            .bg_color, .layer_ctrl, .bitmap_key, .bitmap_rank, .bitmap_fmt, .mark_req, .mark_toggle, .line_start, .line_num,
            .tile_scroll_x, .tile_scroll_y, .tile_map_base, .tile_pat_base, .tile_ctrl,
            .spr_pat_base, .spr_bank, .spr_line_cols, .oam_we, .light_we, .xreg_we, .xreg_idx, .xreg_data,
            .tileb_scroll_x, .tileb_scroll_y, .tileb_map_base, .tileb_pat_base, .tileb_ctrl, .win_h, .win_v, .win_map_base, .hs_mode, .hs_base,
            .vram_we, .vram_waddr, .vram_wdata, .pal_we, .pal_waddr, .pal_wdata,
            .mem_req(fb_req), .mem_addr(fb_addr), .mem_len(fb_len), .mem_ack(fb_ack),
            .mem_rvalid(fb_rvalid), .mem_rdata(m_rdata), .underflow_count,
            .clk_pix, .rst_pix(rst), .x(vx), .y(vy), .rgb(fb_rgb)
        );
        assign comp_busy = u_comp.busy;
    end

    // 音のレジスタ (gpu -> audio_out)
    logic        audio_en, audio_clear, p_req, p_ack, p_rvalid;
    logic [12:0] pcm_base;
    logic [3:0]  pcm_size;
    logic [15:0] pcm_wr;
    logic [20:0] p_addr;

    logic        t3_push, t3_go, t3_busy, t3_error;
    logic [31:0] t3_word;
    logic [12:0] draw_base, z_base;
    logic [8:0]  clip_x0, clip_x1;
    logic [7:0]  clip_y0, clip_y1;
    logic        p_we, p_wnext;
    logic [31:0] p_wdata;
    logic [3:0]  p_wmask;
    logic [8:0]  p_len;

    gpu #(.GPU3D(GPU3D)) u_gpu (
        .ext_valid(1'b0), .ext_word(32'h0), .ext_ready(),
        .clk(clk_sys), .rst, .addr, .wdata, .we, .re, .rdata,
        .mem_req(g_req), .mem_we(g_we), .mem_addr(g_addr), .mem_wdata(g_wdata), .mem_wmask(g_wmask),
        .mem_len(g_len), .mem_ack(g_ack), .mem_wnext(g_wnext), .mem_rvalid(g_rvalid), .mem_rdata(m_rdata),
        .fb_base, .base_latched,
        .bg_color, .layer_ctrl, .bitmap_key, .bitmap_rank, .bitmap_fmt, .mark_req, .line_start, .line_num, .ready(gpu_ready),
        .tile_scroll_x, .tile_scroll_y, .tile_map_base, .tile_pat_base, .tile_ctrl,
        .spr_pat_base, .spr_bank, .spr_line_cols, .oam_we, .light_we, .xreg_we, .xreg_idx, .xreg_data,
        .tileb_scroll_x, .tileb_scroll_y, .tileb_map_base, .tileb_pat_base, .tileb_ctrl, .win_h, .win_v, .win_map_base, .hs_mode, .hs_base,
        .vram_we, .vram_waddr, .vram_wdata, .pal_we, .pal_waddr, .pal_wdata,
        .audio_en, .audio_clear, .pcm_base, .pcm_size, .pcm_wr,
        .t3_push, .t3_word, .t3_go, .t3_busy, .t3_error, .draw_base_o(draw_base), .z_base, .clip_x0, .clip_x1, .clip_y0, .clip_y1
    );

    if (GPU3D != 0) begin : g_tri
        // 3D GPU: 三角形の描画 (アービタの d)。走査・描いたピクセルと busy のクロックを最後に出す (測る用)
        logic [31:0] bin, pairs, prep, fetch, mul, walk, outc, walked, drawn, tlook, tmiss, tstall;
        raster3d u_r3d (
            .clk(clk_sys), .rst,
            .push(t3_push), .word(t3_word), .go(t3_go), .busy(t3_busy), .error(t3_error),
            .draw_base, .z_base, .cx0(clip_x0), .cx1(clip_x1), .cy0(clip_y0), .cy1(clip_y1),
            .mem_req(p_req), .mem_we(p_we), .mem_addr(p_addr), .mem_len(p_len), .mem_wdata(p_wdata), .mem_wmask(p_wmask),
            .mem_ack(p_ack), .mem_wnext(p_wnext), .mem_rvalid(p_rvalid), .mem_rdata(m_rdata),
            .st_bin(bin), .st_pairs(pairs), .st_prep(prep), .st_fetch(fetch), .st_mul(mul), .st_walk(walk), .st_out(outc),
            .st_walked(walked), .st_drawn(drawn), .st_tlook(tlook), .st_tmiss(tmiss), .st_tstall(tstall)
        );
        int d_words = 0, tris = 0, errs = 0;
        always @(posedge clk_sys) begin
            if (p_rvalid || p_wnext) d_words++;
            if (t3_go) tris++;
            if (t3_error) errs++;
        end
        final begin
            $display("  tri: %0d commands, binning %0d cycles, %0d tile pairs, %0d SDRAM words, %0d errors", tris, bin, pairs, d_words, errs);
            $display("  tiles: prep %0d, fetch %0d, mul %0d, walk %0d (walked %0d, drawn %0d), out %0d cycles",
                     prep, fetch, mul, walk, walked, drawn, outc);
            $display("  texture: %0d texel lookups, %0d misses, %0d stall cycles", tlook, tmiss, tstall);
        end
    end else begin : g_audio
        // 音 (K5a): 実機と同じく SDRAM の PCM のリングを読む (I2S の出力は見ない。表示の読み出しの待ちに効かないことを数える)
        assign {p_we, p_wdata, p_wmask, p_len} = {1'b0, 32'h0, 4'h0, 9'd1};
        assign {t3_busy, t3_error} = 2'b00;
        audio_out u_audio (
            .clk(clk_sys), .rst, .enable(audio_en), .clear(audio_clear), .base(pcm_base), .size_log2(pcm_size), .wr(pcm_wr),
            .addr(4'd0), .re(1'b0), .rdata(),
            .mem_req(p_req), .mem_addr(p_addr), .mem_ack(p_ack), .mem_rvalid(p_rvalid), .mem_rdata(m_rdata),
            .bck(), .ws(), .din(), .pa_en()
        );
        final $display("  audio: %0d samples played, %0d underruns", u_audio.rd, u_audio.underrun);
    end

    sdram_arb u_arb (
        .clk(clk_sys), .rst,
        .a_req(fb_req), .a_we(1'b0), .a_addr(fb_addr), .a_wdata(32'h0), .a_wmask(4'h0), .a_len(fb_len),
        .a_ack(fb_ack), .a_rvalid(fb_rvalid), .a_wnext(),
        .b_req(g_req), .b_we(g_we), .b_addr(g_addr), .b_wdata(g_wdata), .b_wmask(g_wmask), .b_len(g_len),
        .b_ack(g_ack), .b_rvalid(g_rvalid), .b_wnext(g_wnext),
        .c_req(1'b0), .c_we(1'b0), .c_addr(21'h0), .c_wdata(32'h0), .c_wmask(4'h0), .c_len(9'd1),
        .c_ack(), .c_rvalid(), .c_wnext(),
        .d_req(p_req), .d_we(p_we), .d_addr(p_addr), .d_wdata(p_wdata), .d_wmask(p_wmask), .d_len(p_len),
        .d_ack(p_ack), .d_rvalid(p_rvalid), .d_wnext(p_wnext),
        .m_req, .m_we, .m_addr, .m_wdata, .m_wmask, .m_len, .m_ack, .m_rvalid, .m_wnext
    );

    logic        cke, cs_n, ras_n, cas_n, we_n, dq_oe;
    logic [1:0]  ba;
    logic [10:0] sa;
    logic [3:0]  dqm;
    logic [31:0] dq_out;
    wire  [31:0] dq;
    assign dq = dq_oe ? dq_out : 'z;

    sdram_ctrl #(.CLK_HZ(63_000_000), .INIT_US(2)) u_ctrl (
        .clk(clk_sys), .rst, .req(m_req), .we(m_we), .addr(m_addr), .wdata(m_wdata), .wmask(m_wmask), .len(m_len),
        .wnext(m_wnext), .ack(m_ack), .rvalid(m_rvalid), .rdata(m_rdata), .init_done, .rd_sample(3'd4),
        .sdram_cke(cke), .sdram_cs_n(cs_n), .sdram_ras_n(ras_n), .sdram_cas_n(cas_n), .sdram_we_n(we_n),
        .sdram_ba(ba), .sdram_addr(sa), .sdram_dqm(dqm), .sdram_dq_out(dq_out), .sdram_dq_oe(dq_oe), .sdram_dq_in(dq)
    );

    sdram_model model (.clk(~clk_sys), .cke, .cs_n, .ras_n, .cas_n, .we_n, .ba, .addr(sa), .dqm, .dq);

    // 1 ラインの合成にかかったクロック数 (line_start から終わるまで、タイルのパスを含む) の最大。予算は 4000 クロック
    int line_cycles = 0, max_line_cycles = 0;
    always @(posedge clk_sys) begin
        if (line_start) line_cycles = 1;
        else if (comp_busy) line_cycles++;
        else if (line_cycles != 0) begin
            if (line_cycles > max_line_cycles) max_line_cycles = line_cycles;
            line_cycles = 0;
        end
    end

    // 表示のライン読み出しの待ち時間 (要求から ack まで、clk_sys のクロック数) の最大。締め切りは出力 2 ライン = 63.5us = 4000 クロック
    int fetch_cycles = 0, max_fetch_cycles = 0;
    always @(posedge clk_sys) begin
        if (fb_req && !fb_ack) fetch_cycles++;
        else begin
            if (fetch_cycles > max_fetch_cycles) max_fetch_cycles = fetch_cycles;
            fetch_cycles = 0;
        end
    end

    // --- バスの操作 ---
    task automatic wr(input logic [6:0] a, input logic [7:0] d);
        @(negedge clk_sys);
        addr = a; wdata = d; we = 1;
        @(negedge clk_sys);
        we = 0;
    endtask

    task automatic rd(input logic [6:0] a, output logic [7:0] d);
        @(negedge clk_sys);
        addr = a;
        #1 d = rdata;
    endtask

    task automatic send_word(input logic [31:0] w);
        logic [7:0] lo, hi;
        do begin
            rd(7'h41, lo); rd(7'h42, hi);
        end while ({hi, lo} == 16'd0);
        wr(7'h30, w[7:0]); wr(7'h30, w[15:8]); wr(7'h30, w[23:16]); wr(7'h30, w[31:24]);
    endtask

    task automatic wait_idle;
        logic [7:0] s;
        do rd(7'h40, s); while (s[0]);
    endtask

    // 次の CRC の更新 (frame_crc がフレームを確定させる) を待つ
    task automatic wait_crc;
        logic t;
        t = crc_toggle;
        wait (crc_toggle != t);
    endtask

    // 次のフレームの画素を集めて PPM に書く (frame_crc と同じ範囲: DE 中の画素)
    logic [7:0] frame_buf [0:640*480*3-1];
    task automatic capture_frame(input string path);
        int n, fd;
        n = 0;
        @(posedge frame_start);
        while (n < 640 * 480) begin
            @(posedge clk_pix);
            if (de) begin
                frame_buf[3 * n] = r; frame_buf[3 * n + 1] = g; frame_buf[3 * n + 2] = b;
                n++;
            end
        end
        fd = $fopen(path, "wb");
        $fwrite(fd, "P6\n640 480\n255\n");
        for (int i = 0; i < 640 * 480 * 3; i++) $fwrite(fd, "%c", frame_buf[i]);
        $fclose(fd);
    endtask

    // 印を付けたフレーム: frame_crc の armed が立ったフレームの画素を集め、mark_count が変わったら CRC を記録する
    logic [7:0] marked_buf [0:640*480*3-1];
    logic [31:0] marked_crc;
    int   marks_done = 0, mcap_n = 0;
    bit   mcap_on = 0, armed_d = 0;
    logic [7:0] mc_d = 0;
    always @(posedge clk_pix) begin
        if (u_crc.armed && !armed_d) begin
            mcap_on = 1;
            mcap_n = 0;
        end
        if (mcap_on && de && mcap_n < 640 * 480) begin
            marked_buf[3 * mcap_n] = r; marked_buf[3 * mcap_n + 1] = g; marked_buf[3 * mcap_n + 2] = b;
            mcap_n++;
        end
        armed_d <= u_crc.armed;
        if (mark_count != mc_d) begin
            marked_crc = held_crc;
            marks_done++;
            mcap_on = 0;
        end
        mc_d <= mark_count;
    end

    task automatic write_ppm(input string path, input bit marked);
        int fd;
        fd = $fopen(path, "wb");
        $fwrite(fd, "P6\n640 480\n255\n");
        for (int i = 0; i < 640 * 480 * 3; i++) $fwrite(fd, "%c", marked ? marked_buf[i] : frame_buf[i]);
        $fclose(fd);
    endtask

    logic [31:0] cmds [0:1048575];
    int          checks [0:255];
    int          kinds [0:255];

    initial begin
        string cmds_path, checks_path, out;
        int n_words, n_checks, fd, sent, i, k, code;
        if (!$value$plusargs("cmds=%s", cmds_path) || !$value$plusargs("checks=%s", checks_path) ||
            !$value$plusargs("out=%s", out)) begin
            $display("FAIL: gpu_scenario_tb needs +cmds= +checks= +out=");
            $finish;
        end
        // ワード数と check の数は最初の行に書いてある
        fd = $fopen(cmds_path, "r");
        code = $fscanf(fd, "%d\n", n_words);
        for (i = 0; i < n_words; i++) code = $fscanf(fd, "%h\n", cmds[i]);
        $fclose(fd);
        fd = $fopen(checks_path, "r");
        code = $fscanf(fd, "%d\n", n_checks);
        for (i = 0; i < n_checks; i++) code = $fscanf(fd, "%d %d\n", checks[i], kinds[i]);
        $fclose(fd);

        repeat (4) @(posedge clk_sys);
        rst = 0;
        wait (init_done);

        sent = 0;
        for (k = 0; k < n_checks; k++) begin
            int marks0;
            logic [31:0] got;
            marks0 = marks_done;
            while (sent < checks[k]) begin
                send_word(cmds[sent]);
                sent++;
            end
            wait_idle();
            if (kinds[k] == 1) begin
                // 印を付けたフレームが終わるのを待つ
                wait (marks_done > marks0);
                got = marked_crc;
                write_ppm($sformatf("%s/frame_%0d.ppm", out, k), 1'b1);
            end else begin
                wait_crc(); wait_crc();
                capture_frame($sformatf("%s/frame_%0d.ppm", out, k));
                wait_crc();    // capture_frame で集めたフレームの CRC
                got = crc;
            end
            fd = $fopen($sformatf("%s/crc_%0d.txt", out, k), "w");
            $fwrite(fd, "%08h %0d %0d %0d %0d\n", got, crc_frame, underflow_count, max_fetch_cycles, max_line_cycles);
            $fclose(fd);
            $display("check %0d (%s): crc %08h frame %0d underflow %0d max_fetch_cycles %0d max_line_cycles %0d", k,
                     kinds[k] == 1 ? "marked" : "normal", got, crc_frame, underflow_count, max_fetch_cycles, max_line_cycles);
        end
        if (model.violations != 0) $display("FAIL: SDRAM model timing violations: %0d", model.violations);
        $display("DONE: gpu_scenario_tb");
        $finish;
    end
endmodule
