fpt/tang-tiny-gpu/sim/tb_raster3d.sv

// 3D GPU の描画部 (G1・G2、rtl/gpu3d/raster3d.sv): SDRAM の代わりのメモリ (返すまでの時間は乱数) で
//   - 同じ乱数の三角形 (単色 / Gouraud、Z あり / なし) を即時モードと TBR (BEGIN_SCENE / END_SCENE) で描き、描く面と Z バッファが全部同じ
//     (即時: 面を消して Z を 0xFFFF にしてから。TBR: 消す色 + clear_z + write_z)
//   - TBR の読み込み (面と Z を消さずに) で、前に描いたものの上に重なる (即時で同じ順に描いたものと同じ)
//   - タイルの上限 (1 タイル 1,024 個) を超えると error が出る
//   - テクスチャ (G3): 8 x 8 のテクスチャを 8 x 8 ピクセルに 1 対 1 で貼り、16bpp はテクセルそのまま、4bpp は CLUT (ずらし込み) の色、
//     色 0 のテクセルは透明 (下の色が残る)
//   - シーンの外の TRI (1 つだけのシーンとして描く): 矩形を 2 つに割った三角形がちょうどその矩形を塗る、Z の規則 (奥と同じ z は描かない)、
//     Gouraud の頂点のそばの色、クリップ矩形の外は書かない
//   - 半透明 (G4、シーンの外の TRI): 4 つの式 (平均、加算、減算、1/4 加算) と加算の飽和、Z はテストするが書かない (奥なら描かない)
`timescale 1ns/1ps
module tb_raster3d;
    logic clk = 0, rst = 1;
    always #5 clk = ~clk;

    logic        push = 0, go = 0, busy, error;
    logic [31:0] word = '0;
    // 描く面 0x1000.. と Z バッファ 0x70000.. (パラメータバッファ 0x20000.. とタイルのリスト 0x40000..0x54000 に重ならないように)
    logic [12:0] draw_base = 13'd16, z_base = 13'd1792;
    logic [8:0]  cx0 = 0, cx1 = 319;
    logic [7:0]  cy0 = 0, cy1 = 239;
    logic        mem_req, mem_we, mem_ack = 0, mem_rvalid = 0;
    logic [20:0] mem_addr;
    logic [8:0]  mem_len;
    logic [31:0] mem_wdata, mem_rdata = '0;
    logic [3:0]  mem_wmask;
    logic [31:0] st_bin, st_pairs, st_prep, st_fetch, st_mul, st_walk, st_out, st_walked, st_drawn, st_tlook, st_tmiss, st_tstall;
    logic        wn = 0;
    logic        mem_wnext;
    assign mem_wnext = wn;
    raster3d dut (.*);

    // SDRAM の代わり (sdram_ctrl と同じ約束)
    logic [31:0] mem [0:524287];
    always begin
        @(negedge clk);
        if (mem_req && !mem_ack) begin
            int n;
            logic [20:0] a;
            n = int'(mem_len);
            a = mem_addr;
            repeat ($urandom_range(2, 12)) @(negedge clk);
            for (int i = 0; i < n; i++) begin
                if (mem_we) begin
                    wn = 1;
                    @(posedge clk);
                    for (int k = 0; k < 4; k++)
                        if (mem_wmask[k]) mem[int'(a) + i] = mem[int'(a) + i] & ~(32'hFF << 8 * k) | (mem_wdata & (32'hFF << 8 * k));
                    @(negedge clk);
                    wn = 0;
                end else begin
                    mem_rvalid = 1;
                    mem_rdata  = mem[int'(a) + i];
                    @(negedge clk);
                    mem_rvalid = 0;
                end
            end
            mem_ack = 1;
            @(negedge clk);
            mem_ack = 0;
        end
    end

    int errors = 0, err_pulses = 0;
    always @(posedge clk) if (error) err_pulses++;

    task automatic cmd1(input logic [31:0] w);           // 1 ワードのコマンド (BEGIN_SCENE / END_SCENE)
        @(negedge clk); push = 1; word = w;
        @(negedge clk); push = 0; go = 1;
        @(negedge clk); go = 0;
        while (busy) @(negedge clk);
    endtask

    // 三角形の列 (乱数、種を固定) を作っておき、同じものを 2 回送る
    localparam int NT = 120;
    logic [31:0] tw [0:NT-1][0:9];
    int          tn [0:NT-1];
    task automatic make_tris(input int seed);
        int s;
        s = seed;
        for (int t = 0; t < NT; t++) begin
            logic [7:0] fl;
            int cx, cy, sz, n;
            fl = {4'b0, 1'(t % 3 != 0), 3'b0} | 8'(t % 2);   // bit3 Z (3 つに 2 つ)、bit0 Gouraud (2 つに 1 つ)
            sz = (t % 5 == 0) ? 3000 : (t % 5 == 1) ? 120 : 600;
            cx = $urandom(s) % 5600 - 200; s = s + 1;
            cy = $urandom(s) % 4200 - 200; s = s + 1;
            n = 0;
            tw[t][n] = {8'h20, fl, 16'($urandom)}; n++;
            for (int v = 0; v < 3; v++) begin
                tw[t][n] = {16'(cy + int'($urandom % 32'(2 * sz)) - sz), 16'(cx + int'($urandom % 32'(2 * sz)) - sz)}; n++;
                if (fl[0]) begin tw[t][n] = {8'h0, 24'($urandom)}; n++; end
                if (fl[3]) begin tw[t][n] = {16'h0, 16'($urandom)}; n++; end
            end
            tn[t] = n;
        end
    endtask
    task automatic send_tris;
        for (int t = 0; t < NT; t++) begin
            for (int i = 0; i < tn[t]; i++) begin
                @(negedge clk); push = 1; word = tw[t][i];
            end
            @(negedge clk); push = 0; go = 1;
            @(negedge clk); go = 0;
            while (busy) @(negedge clk);
        end
    endtask

    // 面と Z の写し
    logic [31:0] ref_c [0:239][0:159];
    logic [31:0] ref_z [0:239][0:159];
    task automatic fill(input logic [12:0] base, input logic [31:0] v);
        for (int y = 0; y < 240; y++) for (int x = 0; x < 160; x++) mem[(int'(base) + y) * 256 + x] = v;
    endtask
    task automatic snap;
        for (int y = 0; y < 240; y++) for (int x = 0; x < 160; x++) begin
            ref_c[y][x] = mem[(int'(draw_base) + y) * 256 + x];
            ref_z[y][x] = mem[(int'(z_base) + y) * 256 + x];
        end
    endtask
    task automatic compare(input string what, input bit with_z);
        int bc, bz;
        bc = 0; bz = 0;
        for (int y = 0; y < 240; y++) for (int x = 0; x < 160; x++) begin
            if (mem[(int'(draw_base) + y) * 256 + x] !== ref_c[y][x]) bc++;
            if (with_z && mem[(int'(z_base) + y) * 256 + x] !== ref_z[y][x]) bz++;
        end
        if (bc != 0 || bz != 0) begin $display("  %s: %0d color words, %0d z words differ", what, bc, bz); errors++; end
    endtask

    // シーンの外の TRI 1 つ (ピクセルの座標、flags: bit0 Gouraud、bit3 Z)
    task automatic send_tri(input logic [7:0] fl, input logic [15:0] col, input int x[3], input int y[3],
                        input logic [23:0] rgb[3], input logic [15:0] z[3]);
        @(negedge clk); push = 1; word = {8'h20, fl, col};
        for (int i = 0; i < 3; i++) begin
            @(negedge clk); word = {16'(y[i] * 16), 16'(x[i] * 16)};
            if (fl[0]) begin @(negedge clk); word = {8'h00, rgb[i]}; end
            if (fl[3]) begin @(negedge clk); word = {16'h0, z[i]}; end
        end
        @(negedge clk); push = 0; go = 1;
        @(negedge clk); go = 0;
        while (busy) @(negedge clk);
    endtask
    function automatic logic [15:0] px(input logic [12:0] base, input int x, input int y);
        logic [31:0] w;
        w = mem[(int'(base) + y) * 256 + x / 2];
        return (x % 2) ? w[31:16] : w[15:0];
    endfunction
    // 矩形 (TRI 2 つ) をシーンの外で
    task automatic send_rect(input logic [7:0] fl, input logic [15:0] col, input int x0, input int y0, input int w, input int h,
                             input logic [15:0] zv);
        int xs[3], ys[3];
        logic [23:0] cs[3];
        logic [15:0] zs[3];
        cs = '{24'h0, 24'h0, 24'h0}; zs = '{zv, zv, zv};
        xs = '{x0, x0 + w, x0 + w}; ys = '{y0, y0, y0 + h}; send_tri(fl, col, xs, ys, cs, zs);
        xs = '{x0, x0 + w, x0};     ys = '{y0, y0 + h, y0 + h}; send_tri(fl, col, xs, ys, cs, zs);
    endtask
    task automatic expect_rect(input string what, input int x0, input int y0, input int w, input int h, input logic [15:0] c,
                               input logic [15:0] outside);
        int bad;
        bad = 0;
        for (int y = y0 - 2; y < y0 + h + 2; y++)
            for (int x = x0 - 2; x < x0 + w + 2; x++) begin
                if (x < 0 || y < 0 || x >= 320 || y >= 240) continue;
                if (px(draw_base, x, y) !== ((x >= x0 && x < x0 + w && y >= y0 && y < y0 + h) ? c : outside)) bad++;
            end
        if (bad != 0) begin $display("  %s: %0d pixels wrong", what, bad); errors++; end
    endtask

    initial begin
        int xs[3], ys[3];
        logic [23:0] cs[3];
        logic [15:0] zs[3];
        $dumpfile("build/sim/tb_raster3d.vcd");
        $dumpvars(0, tb_raster3d);
        repeat (3) @(negedge clk);
        rst = 0;

        // 0. シーンの外の TRI
        fill(draw_base, 32'h0); fill(z_base, 32'hFFFF_FFFF);
        cs = '{24'h0, 24'h0, 24'h0}; zs = '{16'd0, 16'd0, 16'd0};
        xs = '{10, 140, 140}; ys = '{20, 20, 50}; send_tri(8'h00, 16'h1234, xs, ys, cs, zs);
        xs = '{10, 140, 10};  ys = '{20, 50, 50}; send_tri(8'h00, 16'h1234, xs, ys, cs, zs);
        expect_rect("rect 130 x 30", 10, 20, 130, 30, 16'h1234, 16'h0000);
        zs = '{16'd1000, 16'd1000, 16'd1000};
        xs = '{20, 80, 80}; ys = '{150, 150, 200}; send_tri(8'h08, 16'hAAAA, xs, ys, cs, zs);
        xs = '{20, 80, 20}; ys = '{150, 200, 200}; send_tri(8'h08, 16'hAAAA, xs, ys, cs, zs);
        zs = '{16'd2000, 16'd2000, 16'd2000};
        xs = '{0, 100, 0}; ys = '{140, 140, 239}; send_tri(8'h08, 16'hBBBB, xs, ys, cs, zs);
        zs = '{16'd1000, 16'd1000, 16'd1000};
        xs = '{0, 100, 100}; ys = '{140, 140, 239}; send_tri(8'h08, 16'hCCCC, xs, ys, cs, zs);
        if (px(draw_base, 50, 175) !== 16'hAAAA || px(draw_base, 30, 190) !== 16'hAAAA) begin
            $display("  Z: farther or equal z overwrote (%h %h)", px(draw_base, 50, 175), px(draw_base, 30, 190)); errors++;
        end
        if (px(draw_base, 5, 145) !== 16'hBBBB || px(z_base, 5, 145) !== 16'd2000) begin
            $display("  Z: empty area not drawn (%h z %0d)", px(draw_base, 5, 145), px(z_base, 5, 145)); errors++;
        end
        cs = '{24'hFF0000, 24'h00FF00, 24'h0000FF};
        xs = '{150, 310, 150}; ys = '{150, 150, 235}; send_tri(8'h01, 16'h0000, xs, ys, cs, zs);
        begin
            logic [15:0] pr, pg, pb;
            pr = px(draw_base, 151, 151); pg = px(draw_base, 305, 151); pb = px(draw_base, 151, 232);
            if (pr[15:11] < 5'd28 || pg[10:5] < 6'd56 || pb[4:0] < 5'd28) begin
                $display("  Gouraud corners: %h %h %h", pr, pg, pb); errors++;
            end
        end
        // 半透明: 下の色 (16, 32, 16)、描く色 (8, 16, 8)。Z は 2000 で、z 1000 は通り 3000 は通らない
        fill(draw_base, 32'h8410_8410); fill(z_base, 32'h07D0_07D0);
        send_rect(8'h0C, 16'h4208, 10, 60, 20, 10, 16'd1000);         // 平均 (12, 24, 12)
        expect_rect("semi avg", 10, 60, 20, 10, 16'h630C, 16'h8410);
        send_rect(8'h1C, 16'h4208, 40, 60, 20, 10, 16'd1000);         // 加算 (24, 48, 24)
        expect_rect("semi add", 40, 60, 20, 10, 16'hC618, 16'h8410);
        send_rect(8'h2C, 16'h4208, 70, 60, 20, 10, 16'd1000);         // 減算 (8, 16, 8)
        expect_rect("semi sub", 70, 60, 20, 10, 16'h4208, 16'h8410);
        send_rect(8'h3C, 16'h4208, 100, 60, 20, 10, 16'd1000);        // 1/4 加算 (18, 36, 18)
        expect_rect("semi quarter", 100, 60, 20, 10, 16'h9492, 16'h8410);
        send_rect(8'h1C, 16'hFFFF, 130, 60, 20, 10, 16'd1000);        // 加算の飽和
        expect_rect("semi add saturate", 130, 60, 20, 10, 16'hFFFF, 16'h8410);
        send_rect(8'h0C, 16'h4208, 160, 60, 20, 10, 16'd3000);        // 奥なので描かない
        expect_rect("semi behind", 160, 60, 20, 10, 16'h8410, 16'h8410);
        if (px(z_base, 15, 65) !== 16'd2000) begin $display("  semi wrote Z (%0d)", px(z_base, 15, 65)); errors++; end
        send_rect(8'h0C, 16'h4208, 10, 60, 20, 10, 16'd1000);         // 2 回目の平均は 1 回目の結果と混ぜる (10, 20, 10)
        expect_rect("semi avg twice", 10, 60, 20, 10, 16'h528A, 16'h8410);

        fill(draw_base, 32'h0);
        cx0 = 9'd100; cx1 = 9'd120; cy0 = 8'd5; cy1 = 8'd9;
        xs = '{-100, 500, -100}; ys = '{-100, -100, 400}; send_tri(8'h00, 16'h7777, xs, ys, cs, zs);
        expect_rect("clip", 100, 5, 21, 5, 16'h7777, 16'h0000);
        cx0 = 0; cx1 = 319; cy0 = 0; cy1 = 239;

        // 1. 即時 (面を 0x1234 で、Z を 0xFFFF で) → 写し。TBR (消す色 0x1234、clear_z、write_z) で同じに
        make_tris(11);
        fill(draw_base, 32'h1234_1234); fill(z_base, 32'hFFFF_FFFF);
        send_tris();
        snap();
        fill(draw_base, 32'hDEAD_BEEF); fill(z_base, 32'h0BAD_0BAD);
        cmd1({8'h25, 8'h07, 16'h1234});
        send_tris();
        cmd1({8'h26, 24'h0});
        compare("scene (clear) vs immediate", 1);
        $display("  scene: %0d pairs, tiles: prep %0d fetch %0d mul %0d walk %0d out %0d", st_pairs, st_prep, st_fetch, st_mul, st_walk, st_out);

        // 2. 読み込み: 今の面と Z の上に、別の三角形を即時と TBR (消さない、write_z) で
        make_tris(23);
        snap();
        begin
            logic [31:0] save_c [0:239][0:159];
            logic [31:0] save_z [0:239][0:159];
            save_c = ref_c; save_z = ref_z;
            send_tris();                                 // 即時
            snap();
            for (int y = 0; y < 240; y++) for (int x = 0; x < 160; x++) begin      // 元に戻して TBR
                mem[(int'(draw_base) + y) * 256 + x] = save_c[y][x];
                mem[(int'(z_base) + y) * 256 + x] = save_z[y][x];
            end
        end
        cmd1({8'h25, 8'h04, 16'h0});
        send_tris();
        cmd1({8'h26, 24'h0});
        compare("scene (load) vs immediate", 1);

        // 2.5 テクスチャ: 16bpp と 4bpp (CLUT のずらし 16)。TRI 2 つで 8 x 8 の正方形、uv はピクセルと 1 対 1 (テクセルの中心)
        begin
            int bad;
            bad = 0;
            fill(draw_base, 32'h0101_0101);
            for (int v = 0; v < 8; v++) for (int u = 0; u < 4; u++)                       // 16bpp: 4 x 4 テクセルのかたまり (raster.py の tex_index)
                mem[21'h060000 + (v / 4) * 16 + (u / 2) * 8 + (v % 4) * 2 + (u % 2)] = {16'((v * 8 + 2 * u + 1) * 16'h0421), 16'((u == 0 && v == 0) ? 0 : (v * 8 + 2 * u) * 16'h0421)};
            for (int v = 0; v < 8; v++) mem[21'h060100 + v] = {4'(v), 4'(1), 4'(2), 4'(3), 4'(4), 4'(5), 4'(6), 4'(7)};   // 4bpp: 1 行 1 ワード
            // CLUT_WRITE 16 色を 16 番から: 色 = 0x8000 + 番号
            @(negedge clk); push = 1; word = {8'h28, 8'd16, 7'd0, 9'd16};
            for (int i = 0; i < 8; i++) begin                // gpu.sv と同じく 2 クロック以上あけて (上位の色は次のクロックに書く)
                @(negedge clk); push = 1; word = {16'h8000 + 16'(17 + 2 * i), 16'h8000 + 16'(16 + 2 * i)};
                @(negedge clk); push = 0;
            end
            @(negedge clk); push = 0; go = 1;
            @(negedge clk); go = 0;
            while (busy) @(negedge clk);
            for (int f = 0; f < 2; f++) begin
                logic [31:0] base;
                base = f ? 32'h060100 : 32'h060000;
                @(negedge clk); push = 1; word = {8'h21, 6'd0, f ? 2'd2 : 2'd0, f ? 8'd16 : 8'd0, 4'd3, 4'd3};
                @(negedge clk); word = base;
                @(negedge clk); push = 0; go = 1;
                @(negedge clk); go = 0;
                while (busy) @(negedge clk);
                for (int t = 0; t < 2; t++) begin
                    int px[3], py[3];
                    if (t) begin px = '{0, 8, 0}; py = '{0, 8, 8}; end
                    else   begin px = '{0, 8, 8}; py = '{0, 0, 8}; end
                    @(negedge clk); push = 1; word = {8'h20, 8'h02, 16'h0};
                    for (int i = 0; i < 3; i++) begin
                        @(negedge clk); word = {16'((py[i] + 100) * 16), 16'((px[i] + 40 + 20 * f) * 16)};
                        @(negedge clk); word = {16'(py[i] * 64), 16'(px[i] * 64)};
                    end
                    @(negedge clk); push = 0; go = 1;
                    @(negedge clk); go = 0;
                    while (busy) @(negedge clk);
                end
                for (int v = 0; v < 8; v++) for (int u = 0; u < 8; u++) begin
                    logic [15:0] e, gpx;
                    if (f == 0) e = (u == 0 && v == 0) ? 16'h0101 : 16'((v * 8 + u) * 16'h0421);
                    else        e = 16'h8000 + 16'(16 + ((u == 0) ? v : u));          // 4bpp の値 0 は CLUT[16] = 0x8010 (透明ではない)
                    gpx = px(draw_base, 40 + 20 * f + u, 100 + v);
                    if (gpx !== e) begin
                        if (bad < 5) $display("  texture %0d (%0d,%0d): got %h expected %h", f, u, v, gpx, e);
                        bad++;
                    end
                end
            end
            if (bad != 0) errors++;
            $display("  texture: %0d lookups, %0d misses", st_tlook, st_tmiss);
        end

        // 3. タイル 0 に 1,030 個 → 6 回の error
        err_pulses = 0;
        cmd1({8'h25, 8'h03, 16'h0});
        for (int t = 0; t < 1030; t++) begin
            @(negedge clk); push = 1; word = {8'h20, 8'h00, 16'hFFFF};
            @(negedge clk); word = {16'(32), 16'(32)};
            @(negedge clk); word = {16'(32), 16'(80)};
            @(negedge clk); word = {16'(80), 16'(32)};
            @(negedge clk); push = 0; go = 1;
            @(negedge clk); go = 0;
            while (busy) @(negedge clk);
        end
        cmd1({8'h26, 24'h0});
        if (err_pulses != 6) begin $display("  tile overflow: %0d error pulses (expected 6)", err_pulses); errors++; end

        if (errors == 0) $display("PASS: tb_raster3d");
        else             $display("FAIL: tb_raster3d (%0d errors)", errors);
        $finish;
    end

    initial begin
        #2_000_000_000;
        $display("FAIL: tb_raster3d (timeout)");
        $finish;
    end
endmodule
