fpt/tang-tiny-gpu/tools/harness/gpu_model.py

"""コマンド GPU の参照モデルとシナリオ (docs/ARCHITECTURE.md の段階 M5)。Python 標準ライブラリだけで動く

rtl/vdp/gpu.sv と同じ規則でコマンドを解釈し、表示される面の画像と CRC を作る。
同じシナリオから、実機 (harness.py scenario) と Verilator (make scenario) に送る 32bit ワードの列も作る。

シナリオ (JSON):
  {"name": "...", "steps": [
      {"op": "clear", "color": "#rrggbb"},
      {"op": "fill_rect", "x": 0, "y": 0, "w": 10, "h": 10, "color": "#rrggbb"},
      {"op": "swap"},
      {"op": "upload", "addr": 1234, "words": ["deadbeef", ...]},
      {"op": "upload_image", "slot": 256},      # fbmodel.test_image() を slot の面へ
      {"op": "point", "x": 10, "y": 20, "color": "#rrggbb"},                 # 座標は符号付き 16bit
      {"op": "line", "x0": 0, "y0": 0, "x1": 319, "y1": 239, "color": "#rrggbb"},
      {"op": "clip", "x0": 0, "y0": 0, "x1": 319, "y1": 239},               # 両端を含む。FILL_RECT / POINT / LINE / BLIT に効く
      {"op": "upload_sprite", "kind": "arrow", "addr": 196608, "w": 16, "h": 16, "stride": 8},   # 下の sprite_pixels
      {"op": "blit", "src": 196608, "stride": 8, "w": 16, "h": 16, "x": 10, "y": 20,
       "transparent": true, "hflip": false, "vflip": false, "key": "#ff00ff"},
                                                 # 8bpp (bitmap_fmt = 1) のとき: "key" は番号 (0..255)、"src4": true で 4bpp のソース、
                                                 # "bank": 0..15 (4bpp の値の上位)
      {"op": "stretch", "src": 196608, "stride": 8, "sw": 16, "w": 40, "h": 24, "x": 10, "y": 20,
       "sx_step": 26214, "sy_step": 43690, ...},  # STRETCH_BLIT。step は 16.16 (省略すると sw / w と 1.0 から作る:
                                                 # "sh" を書けば sh / h)。ほかのキーは blit と同じ
      {"op": "light_write", "addr": 0, "cells": [[16, 16, 16], ...]},   # ライトマップ (セル cy * 40 + cx、[R, G, B] の倍率 0..63、16 = 1 倍)
      {"op": "pcm_tone", "addr": 2088960, "n": 2048, "tone": 1000},   # 正弦波の PCM (左右同じ、48kHz) を SDRAM に (音のリング用。画には効かない)
      {"op": "upload_image8", "slot": 512},      # 8bpp のテスト画像 (下の test_image8) を slot の面へ
      {"op": "upload_tiles", "kind": "sheet", "addr": 196608},   # tile_words を SDRAM に (4bpp の BLIT のソース。タイル t は addr + 8t、stride 1)
      {"op": "reg", "name": "bg_color", "value": "#rrggbb"},   # 合成のレジスタ (LAYER_REGS の名前)
      {"op": "wait_line", "line": 100},          # 以降の reg がライン 100 から効く
      {"op": "wait_vblank", "mark": true},       # 以降の reg が次のフレームのライン 0 から効く。mark なら次のフレームに印
      {"op": "check"},                           # ここで表示されている画面を比べる (レジスタは最後の値が全ラインに効いている前提)。
                                                 # "capture_min": 0.85 で実機のキャプチャの合格線を下げる (細かい模様の画面)
      {"op": "check_marked"},                    # 印を付けたフレーム (ラインごとのレジスタの変化込み) を比べる
      {"op": "vram_write", "addr": 0, "words": ["deadbeef", ...]},     # VRAM (ワードアドレス、16K ワードで折り返す)
      {"op": "pal_write", "index": 0, "colors": ["#rrggbb", ...]},      # パレット (0..511)
      {"op": "tiles", "kind": "demo", "addr": 0},                        # 下の tile_words (タイル 16 個 = 128 ワード)
      {"op": "m7_tiles", "addr": 4096},          # Mode 7 のタイル 256 個 (8bpp、4096 ワード。下の m7_tile_words)
      {"op": "m7_map", "addr": 0, "kind": "track"},   # Mode 7 のマップ 128 x 128 (4096 ワード。下の m7_map_words)
      {"op": "tilemap", "kind": "demo", "addr": 14336, "w": 32, "h": 28},  # 下の map_entries
      {"op": "palette", "kind": "demo", "index": 0, "count": 64, "offset": 0},  # 下の palette_colors
      {"op": "oam_write", "addr": 0, "words": ["deadbeef", ...]},      # OAM (ワードアドレス、256 ワードで折り返す)
      {"op": "oam", "sprites": [{"x": -4, "y": 10, "w": 2, "h": 1, "tile": 3, "hflip": false, "vflip": false,
                                 "pal": 0, "pri": 0, "order": 0, "bank": 0}, ...]}  # OAM 全体 (書かなかったエントリは無効)。
                                                 # order: 0 列優先、1 16 タイル幅の表、2 行優先。bank: スプライトごとのバンク (spr_bank bit3 のとき)
      {"op": "tri", "v": [[x, y], [x, y], [x, y]], "color": "#rrggbb"}   # 三角形 (3D GPU、raster.py)。座標はピクセル (小数可、1/16 に丸める)。
                                                 # "rgb": ["#..", "#..", "#.."] で Gouraud、"z": [z0, z1, z2] で Z テスト / 書き込み
                                                 # "blend": "avg" / "add" / "sub" / "quarter" で半透明 (G4。Z はテストするが書かない)
      {"op": "clear_z", "value": 65535}         # Z バッファ (Z_BASE、320 x 240 x 16bit) を塗る
      {"op": "begin_scene", "color": "#rrggbb", "clear_z": true, "write_z": false}   # TBR のシーン (G2)。color があれば描く面を
                                                 # その色から、clear_z なら Z を 0xFFFF から (なければ今の面と Z_BASE を読む)。write_z で Z を書き戻す
      {"op": "end_scene"}                       # シーンをタイルごとに描く
      {"op": "upload_tex", "addr": 655360, "fmt": "16", "w": 64, "h": 64, "kind": "checker"}   # テクスチャを SDRAM に (G3)
      {"op": "set_tex", "base": 655360, "fmt": "16", "w": 64, "h": 64, "clut": 0}   # 今のテクスチャ (fmt "16" / "8" / "4")。TRI に "uv": [[u, v], ...] (テクセル)
      {"op": "clut", "index": 0, "colors": ["#rrggbb", ...]}   # CLUT (256 色、8 / 4bpp のテクスチャの色)
      {"op": "demo_setup"}, {"op": "demo_frame", "frame": 120, "mark": true}   # M9 のデモ (demo.py) のコマンド
      {"op": "demo3d_setup", "scene": "tunnel"}, {"op": "demo3d_frame", "scene": "tunnel", "frame": 60}   # G5 の 3D の場面 (demo3d.py)
                                                 # "subdiv": [err, levels] で三角形をホストで割る (demo3d.SUBDIV)、"mip": [bias, levels] でミップマップ (demo3d.MIP)
      {"op": "md_frame", "variant": 0, "mark": true}   # メガドラの形式の決まったフレーム (md.py) を直したもの。印付きの 1 フレーム
  ]}
タイル レイヤの形式は rtl/vdp/tile_layer.sv、スプライト (OAM) は rtl/vdp/sprite_layer.sv。VRAM・パレット・OAM は、
印を付けたフレームの記録中には書かないこと (モデルは最後の内容で合成する)。
色は "#rrggbb" (RGB565 に丸める) か、RGB565 の整数。8bpp (bitmap_fmt = 1) で描くコマンドの色はパレットの番号 (整数、下位 8bit)。
"""
import json

import fbmodel

SRC_W, SRC_H = fbmodel.SRC_W, fbmodel.SRC_H
OP_NOP, OP_CLEAR, OP_FILL_RECT, OP_SWAP, OP_UPLOAD = 0x00, 0x01, 0x02, 0x03, 0x04
OP_POINT, OP_DRAW_LINE, OP_CLIP, OP_BLIT = 0x05, 0x06, 0x07, 0x08
OP_REG_WRITE, OP_WAIT_LINE, OP_WAIT_VBLANK = 0x09, 0x0A, 0x0B
OP_VRAM_WRITE, OP_PAL_WRITE, OP_STRETCH, OP_OAM_WRITE = 0x0C, 0x0D, 0x0E, 0x0F
OP_LIGHT_WRITE = 0x10
OP_TRI, OP_CLEAR_Z = 0x20, 0x24           # 3D GPU (docs/SPECIFICATION_3D.md、3D GPU のビットストリームだけ)
OP_BEGIN_SCENE, OP_END_SCENE = 0x25, 0x26  # 3D GPU の TBR (G2)
OP_SET_TEX, OP_CLUT_WRITE = 0x21, 0x28      # 3D GPU のテクスチャ (G3)
TEX_FMT = {"16": 0, "8": 1, "4": 2}
SCENE_MAX_TRIS, TILE_MAX_TRIS = 4096, 1024  # 1 シーンの三角形、1 タイルのリストの上限 (超えた分は描かない)
LIGHT_W = SRC_W // 8      # ライトマップの 1 行のセル数 (40)
# 合成のレジスタ: 名前 -> (REG_WRITE の番号, ビットの幅のマスク)
LAYER_REGS = {"bg_color": 0, "layer_ctrl": 1, "bitmap_key": 2, "tile_scroll_x": 3, "tile_scroll_y": 4,
              "tile_map_base": 5, "tile_pat_base": 6, "tile_ctrl": 7, "bitmap_rank": 8,
              "spr_pat_base": 9, "spr_bank": 10, "spr_line_px": 11,
              "tileb_scroll_x": 12, "tileb_scroll_y": 13, "tileb_map_base": 14, "tileb_pat_base": 15, "tileb_ctrl": 16,
              "win_h": 17, "win_v": 18, "win_map_base": 19, "hscroll_mode": 20, "hscroll_base": 21,
              "bitmap_fmt": 22, "audio_ctrl": 23, "pcm_base": 24, "pcm_size": 25, "pcm_wr": 26, "z_base": 27,
              "m7_sel": 32, "m7_ctrl": 33, "m7_a": 34, "m7_b": 35, "m7_c": 36, "m7_d": 37,
              "m7_x0": 38, "m7_y0": 39, "m7_hofs": 40, "m7_vofs": 41, "m7_map_base": 42, "m7_pat_base": 43,
              "m7_tbl_base": 44, "m7_sx": 45, "m7_sy": 46,
              "line_mul": 47, "line_add": 48, "line_fx_ctrl": 49, "line_fx_base": 50}
LAYER_MASK = {"bg_color": 0xFFFF, "layer_ctrl": 0x3F, "bitmap_key": 0xFFFF, "tile_scroll_x": 0x3FF, "tile_scroll_y": 0x3FF,
              "tile_map_base": 0x3FFF, "tile_pat_base": 0x3FFF, "tile_ctrl": 0xFF, "bitmap_rank": 0x7,
              "spr_pat_base": 0x3FFF, "spr_bank": 0xF, "spr_line_px": 0x3FF,
              "tileb_scroll_x": 0x3FF, "tileb_scroll_y": 0x3FF, "tileb_map_base": 0x3FFF, "tileb_pat_base": 0x3FFF,
              "tileb_ctrl": 0xFF, "win_h": 0x9F, "win_v": 0x9F, "win_map_base": 0x3FFF, "hscroll_mode": 0x3,
              "hscroll_base": 0x3FFF, "bitmap_fmt": 0x1, "audio_ctrl": 0x3, "pcm_base": 0x1FFF, "pcm_size": 0xF,
              "pcm_wr": 0xFFFF, "z_base": 0x1FFF,
              "m7_sel": 0xC3, "m7_ctrl": 0xF, "m7_a": 0xFFFF, "m7_b": 0xFFFF, "m7_c": 0xFFFF, "m7_d": 0xFFFF,
              "m7_x0": 0x1FFF, "m7_y0": 0x1FFF, "m7_hofs": 0x1FFF, "m7_vofs": 0x1FFF, "m7_map_base": 0x3FFF,
              "m7_pat_base": 0x3FFF, "m7_tbl_base": 0x3FFF, "m7_sx": 0x3FF, "m7_sy": 0x1FF,
              "line_mul": 0x7FFF, "line_add": 0xFFFF, "line_fx_ctrl": 0x1, "line_fx_base": 0x3FFF}
LAYER_RESET = {"bg_color": 0x0000, "layer_ctrl": 0x01, "bitmap_key": 0x0000, "tile_scroll_x": 0, "tile_scroll_y": 0,
               "tile_map_base": 0, "tile_pat_base": 0, "tile_ctrl": 0, "bitmap_rank": 1,
               "spr_pat_base": 0, "spr_bank": 0, "spr_line_px": 320,
               "tileb_scroll_x": 0, "tileb_scroll_y": 0, "tileb_map_base": 0, "tileb_pat_base": 0, "tileb_ctrl": 0,
               "win_h": 0, "win_v": 0, "win_map_base": 0, "hscroll_mode": 0, "hscroll_base": 0, "bitmap_fmt": 0,
               "audio_ctrl": 0, "pcm_base": 0x1FE0, "pcm_size": 11, "pcm_wr": 0, "z_base": 0x0E00,
               "m7_sel": 0, "m7_ctrl": 0, "m7_a": 0x100, "m7_b": 0, "m7_c": 0, "m7_d": 0x100,
               "m7_x0": 0, "m7_y0": 0, "m7_hofs": 0, "m7_vofs": 0, "m7_map_base": 0, "m7_pat_base": 0,
               "m7_tbl_base": 0, "m7_sx": 0, "m7_sy": 0,
               "line_mul": 0x4210, "line_add": 0, "line_fx_ctrl": 0, "line_fx_base": 0}
# Mode 7 (m7_*) と霧 (line_*) は E7 (rtl/vdp/mode7_layer.sv、line_compositor.sv)。
# 音のレジスタ (audio_ctrl 〜 pcm_wr) は画に効かない。参照モデルは値を持つだけ (音は audio_out.sv と harness.py audio で確かめる)
# 合成の順位 (line_compositor.sv): 0 背景色、面 B は優先度ビットで 1 か 4、面 A (とウィンドウ) は 2 か 5、スプライトは 3 か 6、
# ビットマップは bitmap_rank
RANK_B_LO, RANK_B_HI = 1, 4
RANK_A_LO, RANK_A_HI = 2, 5
RANK_S_LO, RANK_S_HI = 3, 6
OAM_WORDS = 256
VRAM_WORDS = 16384
BLIT_MAX_W = 512
STRETCH_MAX = 1024       # STRETCH_BLIT の描く大きさの上限
SPRITE_KEY = 0xF81F      # sprite_pixels が透過色に使う色 (#ff00ff)
FB_BASE_RESET, DRAW_BASE_RESET = 0, 256


def color565(c):
    if isinstance(c, int):
        return c & 0xFFFF
    c = c.lstrip("#")
    return fbmodel.to565(int(c[0:2], 16), int(c[2:4], 16), int(c[4:6], 16))


def encode(step):
    """1 つのステップを GPU に送るワードの列にする (check は送らない)"""
    op = step["op"]
    if op == "clear":
        return [OP_CLEAR << 24 | color565(step["color"])]
    if op == "fill_rect":
        return [OP_FILL_RECT << 24 | color565(step["color"]),
                (step["y"] & 0xFFFF) << 16 | (step["x"] & 0xFFFF),
                (step["h"] & 0xFFFF) << 16 | (step["w"] & 0xFFFF)]
    if op == "swap":
        return [OP_SWAP << 24]
    if op == "upload":
        words = [int(w, 16) if isinstance(w, str) else w for w in step["words"]]
        return [OP_UPLOAD << 24 | len(words), step["addr"]] + words
    if op == "upload_image":
        img = fbmodel.rgb_to_565(fbmodel.test_image(), SRC_W, SRC_H)
        return upload_image_words(img, step["slot"])
    if op == "point":
        return [OP_POINT << 24 | color565(step["color"]), xy(step["x"], step["y"])]
    if op == "line":
        return [OP_DRAW_LINE << 24 | color565(step["color"]), xy(step["x0"], step["y0"]), xy(step["x1"], step["y1"])]
    if op == "clip":
        return [OP_CLIP << 24, xy(step["x0"], step["y0"]), xy(step["x1"], step["y1"])]
    if op == "blit":
        flags = ((1 if step.get("transparent") else 0) | (2 if step.get("hflip") else 0) | (4 if step.get("vflip") else 0)
                 | (8 if step.get("src4") else 0))
        key = (step.get("bank", 0) & 15) << 8 if step.get("src4") else color565(step.get("key", SPRITE_KEY))
        return [OP_BLIT << 24 | flags << 16 | key, step["src"],
                (step["h"] & 0xFFFF) << 16 | (step["w"] & 0xFFFF), xy(step["x"], step["y"]), step["stride"] & 0xFFFF]
    if op == "stretch":
        flags = ((1 if step.get("transparent") else 0) | (2 if step.get("hflip") else 0) | (4 if step.get("vflip") else 0)
                 | (8 if step.get("src4") else 0))
        key = (step.get("bank", 0) & 15) << 8 if step.get("src4") else color565(step.get("key", SPRITE_KEY))
        xs = step.get("sx_step", step["sw"] * 65536 // step["w"])
        ys = step.get("sy_step", step["sh"] * 65536 // step["h"] if "sh" in step else 65536)
        return [OP_STRETCH << 24 | flags << 16 | key, step["src"], (step["h"] & 0xFFFF) << 16 | (step["w"] & 0xFFFF),
                xy(step["x"], step["y"]), (step["sw"] & 0xFFFF) << 16 | (step["stride"] & 0xFFFF), xs & 0xFFFFFFFF, ys & 0xFFFFFFFF]
    if op == "light_write":
        return light_write_words(step["addr"], step["cells"])
    if op == "pcm_tone":
        import math
        words = []
        for k in range(step["n"]):
            v = int(round(8000 * math.sin(2 * math.pi * step["tone"] * k / 48000))) & 0xFFFF
            words.append(v << 16 | v)
        return [OP_UPLOAD << 24 | len(words), step["addr"]] + words
    if op == "upload_image8":
        img = test_image8()
        out = []
        for y in range(SRC_H):
            words = [sum(img[y * SRC_W + 4 * k + n] << 8 * n for n in range(4)) for k in range(SRC_W // 4)]
            out += [OP_UPLOAD << 24 | len(words), (step["slot"] + y) * fbmodel.WORDS_PER_LINE] + words
        return out
    if op == "upload_tiles":
        words = tile_words(step["kind"])
        return [OP_UPLOAD << 24 | len(words), step["addr"]] + words
    if op == "upload_sprite":
        px = sprite_pixels(step["kind"], step["w"], step["h"])
        return image_words(px, step["w"], step["h"], step["stride"], step["addr"])
    if op == "reg":
        v = step["value"]
        v = color565(v) if isinstance(v, str) else v & 0xFFFF
        return [OP_REG_WRITE << 24 | LAYER_REGS[step["name"]] << 16 | v]
    if op == "wait_line":
        return [OP_WAIT_LINE << 24 | (step["line"] & 0xFF)]
    if op == "wait_vblank":
        return [OP_WAIT_VBLANK << 24 | (1 if step.get("mark") else 0)]
    if op == "vram_write":
        return vram_write_words(step["addr"], [int(w, 16) if isinstance(w, str) else w for w in step["words"]])
    if op == "pal_write":
        return pal_write_words(step["index"], [color565(c) for c in step["colors"]])
    if op == "tiles":
        return vram_write_words(step["addr"], tile_words(step["kind"]))
    if op == "m7_tiles":
        return vram_write_words(step["addr"], m7_tile_words())
    if op == "m7_map":
        return vram_write_words(step["addr"], m7_map_words(step.get("kind", "track")))
    if op == "tilemap":
        return vram_write_words(step["addr"], map_words(map_entries(step["kind"], step["w"], step["h"])))
    if op == "palette":
        return pal_write_words(step["index"], palette_colors(step["kind"], step["count"], step.get("offset", 0)))
    if op == "oam_write":
        return oam_write_words(step["addr"], [int(w, 16) if isinstance(w, str) else w for w in step["words"]])
    if op == "oam":
        return oam_write_words(0, oam_words(step["sprites"]))
    if op == "tri":
        return tri_words(step)
    if op == "begin_scene":
        flags = (1 if "color" in step else 0) | (2 if step.get("clear_z") else 0) | (4 if step.get("write_z") else 0)
        return [OP_BEGIN_SCENE << 24 | flags << 16 | (color565(step["color"]) if "color" in step else 0)]
    if op == "end_scene":
        return [OP_END_SCENE << 24]
    if op == "set_tex":
        import raster
        fmt, wl, hl = TEX_FMT[str(step.get("fmt", "16"))], int(step["w"]).bit_length() - 1, int(step["h"]).bit_length() - 1
        assert step["base"] % (1 << (wl + hl - raster.TEX_SHIFT[fmt])) == 0, "set_tex: base はテクスチャのワード数の倍数にする"
        return [OP_SET_TEX << 24 | fmt << 16 | (step.get("clut", 0) & 0xFF) << 8 | wl << 4 | hl, step["base"] & 0x1FFFFF]
    if op == "clut":
        cols = [color565(c) for c in step["colors"]]
        n = len(cols)
        ws = [cols[i] | (cols[i + 1] << 16 if i + 1 < n else 0) for i in range(0, n, 2)]
        return [OP_CLUT_WRITE << 24 | (step.get("index", 0) & 0xFF) << 16 | n] + ws
    if op == "upload_tex":
        fmt = TEX_FMT[str(step.get("fmt", "16"))]
        words = tex_words(fmt, step["w"], step["h"], step.get("kind", "checker"), step.get("seed", 1))
        return [OP_UPLOAD << 24 | len(words), step["addr"]] + words
    if op == "clear_z":
        return [OP_CLEAR_Z << 24 | (step.get("value", 0xFFFF) & 0xFFFF)]
    if op == "md_frame":
        import md
        return md.translate(md.synthetic(step.get("variant", 0)), step.get("mark", True))[0]
    if op == "demo_setup":
        import demo
        return demo.setup_words()
    if op == "demo_frame":
        import demo
        return demo.frame_words(step["frame"], step.get("mark", False))
    if op == "demo3d_setup":
        import demo3d
        return demo3d.setup_words(step["scene"])
    if op == "demo3d_frame":
        import demo3d
        saved = demo3d.SUBDIV, demo3d.MIP
        if "subdiv" in step:                       # [err, levels]: 三角形をホストで割る (demo3d.SUBDIV)
            demo3d.SUBDIV = {"err": step["subdiv"][0], "levels": step["subdiv"][1]}
        if "mip" in step:                          # [bias, levels]: 三角形ごとにミップマップの段を選ぶ (demo3d.MIP)
            demo3d.MIP = {"bias": step["mip"][0], "levels": step["mip"][1]}
        try:
            return demo3d.frame_words(step["scene"], step["frame"])
        finally:
            demo3d.SUBDIV, demo3d.MIP = saved
    if op in ("check", "check_marked"):
        return []
    raise ValueError(f"unknown op {op!r}")


def tri_words(step):
    """TRI のワード列: [0x20 | flags | 単色 565]、頂点ごとに {y, x} (12.4)、Gouraud なら {r, g, b}、Z なら {z}、テクスチャなら {v, u} (10.6)。
    "blend" があれば半透明 (flags bit2 と [5:4] の式)"""
    import raster
    gouraud, zs, uv = "rgb" in step, step.get("z"), step.get("uv")
    flags = ((raster.FLAG_GOURAUD if gouraud else 0) | (raster.FLAG_Z if zs is not None else 0)
             | (raster.FLAG_TEX if uv is not None else 0))
    if "blend" in step:                     # 半透明: "avg" / "add" / "sub" / "quarter" (raster.blend)
        flags |= raster.FLAG_SEMI | ["avg", "add", "sub", "quarter"].index(step["blend"]) << 4
    words = [OP_TRI << 24 | flags << 16 | (color565(step["color"]) if "color" in step else 0)]
    for k, (x, y) in enumerate(step["v"]):
        xi, yi = int(round(x * 16)), int(round(y * 16))
        words.append((yi & 0xFFFF) << 16 | (xi & 0xFFFF))
        if gouraud:
            c = step["rgb"][k].lstrip("#")
            words.append(int(c, 16))
        if zs is not None:
            words.append(zs[k] & 0xFFFF)
        if uv is not None:
            u, v = (int(round(t * 64)) & 0xFFFF for t in uv[k])     # 10.6
            words.append(v << 16 | u)
    return words


def tex_words(fmt, w, h, kind="checker", seed=1):
    """テクスチャの中身 (raster.py の並び。8 ワードのかたまり)。16bpp は RGB565、8 / 4bpp は CLUT の番号。checker: 市松と縞、0 (透明) のところもある"""
    import random
    import raster
    rng = random.Random(seed)
    sh = {0: 1, 1: 2, 2: 3}[fmt]
    words = [0] * ((w * h) >> sh)
    for v in range(h):
        for u in range(w):
            if kind == "checker":
                c = ((u >> 2) ^ (v >> 2)) & 1
                val = (0x07E0 if c else 0xF800) ^ ((u * 37 + v * 11) & 0x1F) if fmt == 0 else (1 + c * 3 + ((u + v) >> 3)) % (256 if fmt == 1 else 16)
                if (u + 2 * v) % 13 == 0:
                    val = 0
            else:
                val = rng.randrange(1 << 16) if fmt == 0 else rng.randrange(256 if fmt == 1 else 16)
            a = raster.tex_index(fmt, int(w).bit_length() - 1, u, v)
            if fmt == 0:
                words[a] |= val << (16 * (u & 1))
            elif fmt == 1:
                words[a] |= val << (8 * (u & 3))
            else:
                words[a] |= val << (28 - 4 * (u & 7))
    return words


def layer_reset_words():
    """合成のレジスタを既定に戻す REG_WRITE の列 (シナリオを始める前に送る)"""
    return [OP_REG_WRITE << 24 | LAYER_REGS[k] << 16 | v for k, v in LAYER_RESET.items()]


def vram_write_words(addr, words):
    return [OP_VRAM_WRITE << 24 | len(words), addr] + list(words)


def light_write_words(addr, cells):
    """ライトマップのセル ([R, G, B] の倍率) を LIGHT_WRITE に"""
    words = [(r & 63) | (g & 63) << 8 | (b & 63) << 16 for r, g, b in cells]
    return [OP_LIGHT_WRITE << 24 | len(words), addr] + words


def lit(c, cell):
    """line_compositor.sv と同じ: RGB565 の各色に倍率 (16 = 1 倍) を掛けて >> 4、最大値で切る"""
    r, g, b = cell
    return (min(31, (c >> 11) * r >> 4) << 11 | min(63, (c >> 5 & 63) * g >> 4) << 5 | min(31, (c & 31) * b >> 4))


def add565(c, k):
    """line_compositor.sv と同じ: RGB565 の各色に足して最大値で切る (霧の LINE_ADD)"""
    return (min(31, (c >> 11) + (k >> 11)) << 11 | min(63, (c >> 5 & 63) + (k >> 5 & 63)) << 5
            | min(31, (c & 31) + (k & 31)))


def sext(v, bits):
    v &= (1 << bits) - 1
    return v - (1 << bits) if v >> (bits - 1) else v


def m7_clip(n):
    """bsnes と同じ: 14bit の差を 11bit の符号付きに"""
    return (n | ~1023) if n & 0x2000 else (n & 1023)


def oam_write_words(addr, words):
    return [OP_OAM_WRITE << 24 | len(words), addr] + list(words)


def oam_entry(sp):
    """スプライト 1 つ (辞書) を OAM の 2 ワードに (sprite_layer.sv の形式)"""
    order = int(sp.get("order", 0))        # True / False も 1 / 0 として受ける
    w0 = (sp["x"] & 0x3FF | (order >> 1 & 1) << 10 | (sp["y"] & 0x3FF) << 16 | (sp.get("w", 1) - 1) << 26
          | (sp.get("h", 1) - 1) << 28 | (order & 1) << 30 | (0 if sp.get("enable", True) is False else 1) << 31)
    w1 = (sp.get("tile", 0) & 0x7FF | (1 if sp.get("hflip") else 0) << 11 | (1 if sp.get("vflip") else 0) << 12
          | (sp.get("pal", 0) & 3) << 13 | (1 if sp.get("pri") else 0) << 15 | (sp.get("bank", 0) & 15) << 16)
    return [w0, w1]


def oam_words(sprites):
    """OAM 全体 (128 エントリ)。sprites の後ろのエントリは無効"""
    if len(sprites) > 128:
        raise ValueError("more than 128 sprites")
    out = []
    for sp in sprites:
        out += oam_entry(sp)
    return out + [0] * (OAM_WORDS - len(out))


def s10(v):
    v &= 0x3FF
    return v - 0x400 if v & 0x200 else v


def pal_write_words(index, colors):
    padded = list(colors) + [0] * (len(colors) % 2)
    return [OP_PAL_WRITE << 24 | len(colors), index] + [padded[k] | padded[k + 1] << 16 for k in range(0, len(padded), 2)]
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
