fpt/tang-tiny-gpu/(commit log)

2026-11-02 docs: SPECIFICATION_3D.md, a self-contained spec for the 3D GPU bitstream
    - 概要、ビットストリームの切り替え (RECONFIG、multiboot)、レジスタ (3D で意味のあるもの、REG_WRITE の Z_BASE)、コマンド (2D の残り + 3D)、
    三角形の形と描く規則、半透明、テクスチャ (SET_TEX、8 ワードのかたまりの並び、CLUT、キャッシュ)、シーン、SDRAM の配置、速さ、制限、
    1 フレームの組み立て方、検証の手がかり
    - SPECIFICATION.md は VDP の仕様と明記し、14 章は SPECIFICATION_3D.md へのリンクに
2026-11-02 README: describe the project as two switchable bitstreams (VDP and 3D GPU)
    - 題名を tang-tiny-gpu に。VDP と 3D GPU を RECONFIG で入れ替える構成、今の状態 (各計画の段階、リンク、本番のファームウェアは雛形)、
    文書の一覧、今の make のコマンド、ハーネスの使い方、実際のディレクトリ構成、ピン 9 (RECONFIG_N)
2026-11-02 docs: ARCHITECTURE.md gathers the design that is still valid
    Two bitstreams and switching, clocks, SDRAM phase, VDP line compositing,
    the 3D GPU (setup, binning, tile pass stages, texture cache), lessons from
    Gowin + open-source tools, host link, the stage glossary (M/E/K/G) and the
    rs-kessel rules, taken from the plan documents before removing them.
2026-11-02 docs: remove the plans, reviews, timing note and old wiring docs
    GPU_PLAN, EMU_GPU_PLAN, GPU3D_PLAN, KESSEL_ON_VDP, pre_G4/G6 reviews,
    NEXTPNR_GOWIN_TIMING (moved out of the repo), BASEBOARD (QSPI plan, superseded
    by HARNESS2) and WIRING (v1 wiring, covered by HARNESS and SPECIFICATION).
    Links in the remaining docs point to ARCHITECTURE.md instead.
2026-11-02 Point code comments, CLAUDE.md and README at ARCHITECTURE.md
    The stage names (M/E/K/G) in comments now refer to the stage table in
    ARCHITECTURE.md; tool lessons refer to its chapter 10. Also drop the stale
    TARGET= mentions left in top.sv and the scenario testbench.
2026-11-03 Add LICENSE.txt: Solderpad Hardware License v2.1 (or Apache-2.0)
    SHL-2.1 is a wraparound of Apache-2.0 that also covers hardware rights
    (designs, bitstreams, mask works). The file carries the SHL-2.1 text and the
    full Apache-2.0 text it incorporates, both from the SPDX license list.
2026-11-03 README: new hardware capture of the four 3D scenes (city with roofs)
    Captured from scenario g5_scenes on hardware (all five checks match the
    reference model's CRC; captures 99.9%+). Logo frame 150, tunnel 300, room 120,
    city 200, each scaled to 320x240.
2026-11-03 docs: call the 3D GPU tile-based rendering (TBR), not TBDR
    It bins triangles and shades each pixel that passes the Z test in the same
    pass (no hidden-surface removal before shading as in PowerVR's ISP -> TSP),
    so it is TBR like Mali and Adreno. ARCHITECTURE.md now says why. The
    scenario name g2_tbdr is kept as an identifier.
2026-11-08 harness: use the V-Z632 capture and decode its YUV as BT.709
    The new MacroSilicon capture (USB 3, 640x480 at a measured 60fps,
    uncompressed UYVY) encodes BT.709 limited range. Decoding with ffmpeg's
    default BT.601 shifted pure colours by up to ~40 and failed frametest; with
    BT.709 frametest is 100%, m7_blit 98.5% (was 96.9%), and all 2D and 3D
    scenarios pass. HARNESS_CAPTURE_MATRIX selects the matrix for other devices.
    [imgcmp.py]
2026-11-10 harness: kicad-check (wiring, routing, shorts and gerbers of the KiCad board)
    - scripts/kicad_check.py (stdlib only): compares the .kicad_pcb with the
    pins file (Pico pin <-> FPGA pin, series resistors and pull-downs with
    values, GND, no supply ties), checks that every net's pads are one copper
    island, and finds shorts / clearance violations with exact pad shapes
    (round-rect, oval, custom). With --gerbers it repeats routing and shorts
    on the fab files using the X2 net/pad attributes and flags stale gerbers
    - make kicad-check (KICAD_PCB / KICAD_PINS / KICAD_GERBERS)
    - .claude/skills/kicad-check: how to run it and read the result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
2026-11-10 harness v2: HARNESS=v2 switch and the wiring-probe bitstream (probe2)
    HARNESS=v2 selects pins_v2.json, the pico2 / rp2350-arm-s firmware build
    (harness/firmware/build_v2) and the v2 pincheck. top_harness_probe_v2 toggles
    CIPO / IRQ / VSYNC, and echoes the number of the asserted Pico -> FPGA line
    (9 lines) as two 2-bit halves on {IRQ, CIPO}, split by VSYNC. SCK / COPI idle
    high (on-board LEDs) and are asserted low; HSTX_CLK (pin 80, GCLKT_0) is taken
    as a clock because it does not read as data with the OSS tools.
2026-11-10 harness bridge: build for v2 (Pico 2) and the v2 wiretest
    pins.h carries idle_high from pins_v2.json (SCK, COPI, HSTX_CLK idle high).
    v1 / v2 split on PIN_HEARTBEAT: SPI instance from the SCK GPIO, ready from
    VSYNC on v2, v2 wiretest that decodes the probe's echo code with a 10us guard
    after VSYNC edges and a 90% majority (pin 52 shares HDMI DDC_CLK and its edges
    wobble). Lines that idle high are released with a pull-up; HSTX lines are
    driven low before release (RP2350-E9). HARNESS_RAM=1 builds a no_flash UF2
    that runs from SRAM and leaves the Pico's flash alone.
    [main.c]
2026-11-10 docs: harness v2 wiring test and what it found
2026-11-10 harness v2: VDP / 3D GPU bitstreams with v2 pins (vdp2, gpu3d2)
    top_v2 wraps top and exposes only the v2 harness pins (SPI 20/19/75/86,
    IRQ 85, VSYNC 52, RESET 79); HEARTBEAT, ERROR and LED4/5 stay inside. With
    HARNESS=v2, bitstream / prog / prog-3d / flash use vdp2 / gpu3d2. SEED= passes
    --seed to nextpnr for the two-seed hardware check.
    [top_v2.sv]
2026-11-10 harness.py: selftest on v2 (VSYNC instead of HEARTBEAT); wait for capture relock
    selftest uses VSYNC for ready and the RESET check when the bridge reports no
    HEARTBEAT, and skips the LED item. Captures retry for up to 5 s while the
    frame is blank but the expected image is not: after RECONFIG the V-Z632 takes
    1-2 s to lock onto HDMI again, so the first check after a switch read 0%.
    [harness.py, imgcmp.py]
2026-11-10 docs: harness v2 runs the VDP and 3D GPU over SPI
2026-11-10 harness.py: stop demos at a frame boundary on Ctrl-C; recover a stuck 3D GPU
    Ctrl-C during a stream cut a command in half; the 3D GPU then waited for the
    rest and stayed busy, and since it has no flush (GPU_STATUS bit0 is VDP only)
    every later demo or scenario failed with "GPU stays busy" until a reset.
    demo now turns SIGINT into a flag checked between frames, and Gpu.flush
    pulses RESET when the GPU is still busy 200 ms after the flush.
    [harness.py]
2026-11-10 harness: default back to the MS2109 capture; pick the YUV matrix from the device
    The V-Z632 misses saturated colours (g2_tbdr 94.7%, g4_semi 84%, CRCs exact)
    where the MS2109 gives 98.7% / 93.6%. Use the MS2109 by default so harness v1
    and v2 are compared on the same capture. The decode matrix now follows the
    device (V-Z632 -> bt709, others -> bt601), so HARNESS_CAPTURE=V-Z632 alone
    selects the new capture.
2026-11-11 hstx_rx: HSTX receiver (DDR nibbles, async byte FIFO, packet parser); gpu word input
    hstx_rx takes the RP2350 HSTX clock and four data lines (one nibble per
    clock edge, CLKDIV=2 / CLKPHASE=1 on the RP2350), crosses into clk with a
    16-byte gray-pointer FIFO, finds packets (magic 55 AA 5A A5, length, words,
    CRC-16 CCITT, 2 pad bytes) and hands words out with valid/ready. Counters for
    good packets, CRC errors, sync errors, dropped bytes and payload bytes.
    gpu gets ext_valid / ext_word / ext_ready next to the CMD register path; the
    register's 4th byte wins a tie and the external word waits.
    tb_hstx_rx: ordering, CRC / sync errors, empty packet, stalls, and a 75MHz
    clk_hstx (37.5MB/s). Passes i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
    [gpu.sv, gpu_scenario_tb.sv, hstx_rx.sv, tb_gpu.sv, tb_hstx_rx.sv]
2026-11-11 hstx_rx: fixes from bring-up on the board
    - No pad bytes: magic + length + 4n + CRC is already a multiple of 4.
    - FIFO pointers are not reset. With an async clear on the falling-edge
    write side (DFFNC) the write pointer never advanced on the board; both
    sides now start at 0 from configuration and keep counting.
    - Writing 0x60 (stat_clear) also restarts the parser at the magic, so a
    half-received packet from an earlier failed run cannot swallow the next.
    - Debug outputs for the two FIFO pointers.
    - Only the last byte of a word waits for the previous word to be taken.
    [hstx_rx.sv, tb_hstx_rx.sv, top_core.sv]
2026-11-11 top_core: HSTX receiver in the harness v2 bitstreams
    top.sv becomes top_core.sv with an HSTX parameter and hstx_clk / hstx_d
    inputs; top.sv (v1) wraps it with HSTX off, top_v2.sv wires pins 80 (clock,
    GCLKT_0) and 71-74. The receiver feeds the GPU command FIFO next to the
    CMD register, and its counters are readable at 0x60-0x69.
2026-11-11 harness bridge: HSTX commands (v2)
    hstx <sys|usb> <div 1..4> sets clk_hstx (its divider is only 2 bits) and
    reports the measured frequency; nibble per clk_hstx cycle, clock with
    CLKDIV 2 / CLKPHASE 1. hstxw sends one packet after checking GPU_FREE over
    SPI; hstxload builds packets (with CRC) in a 192KB RAM buffer and hstxrep
    replays them by DMA, waiting for room that covers the packet, the DMA still
    in flight and a 32-word margin. hstxprobe counts pin edges for debugging.
    wiretest switches HSTX off first.
2026-11-11 harness.py: --link hstx, hstxbench, hstxdemo
    --link hstx sends GPU commands as 128-word HSTX packets (registers stay on
    SPI); --hstx picks the speed (usb4 ... sys2). hstxbench replays NOPs from
    the Pico's RAM and checks the FPGA's receive counters; hstxdemo replays G5
    scene frames to measure fps without USB in the way. SPI runs at 8MHz while
    replaying so the GPU_FREE reads don't limit the link.
2026-11-11 demo3d: split textured triangles on the host (PS1-style), opt-in
    Each clipped textured triangle is split at 3D edge midpoints, so new
    vertices carry exact position, uv, colour and Z. An edge splits when its
    midpoint's affine error, about L |za - zb| / (2 (za + zb)) pixels, exceeds
    SUBDIV['err'] and the edge has been split fewer than SUBDIV['levels'] times.
    The decision depends only on the edge, so neighbours split the same way and
    no T-junction cracks appear. 1/2/3 split edges give 2/3/4 triangles.
    Off by default (SUBDIV = None). 'python3 demo3d.py compare <scene> <frame>
    <png>' renders the reference model without and with it side by side.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
    [demo3d.py]
2026-11-11 harness: --subdiv for demo / hstxdemo; scenario g6_subdiv
    demo3d_frame steps take "subdiv": [err, levels]. g6_subdiv renders tunnel,
    room and city frames split at 2px / 3 levels (7,000-20,000 words per frame).
2026-11-11 demo3d: per-triangle mipmap level chosen on the host, opt-in
    Textures get levels 1-3 (32/16/8 texels, 2x2 box filter) in a 2,048-word
    slot after the originals, at offsets 0/512/640 so each base is a multiple of
    its word count. With MIP set, each textured triangle picks
    level = floor(log2(sqrt(A_tex / A_scr)) + bias) in 0..3, scales its uv by
    1/2^level and emits that level's SET_TEX. 'compare' takes a mode
    (subdiv / mip / subdiv+mip).
